Kiogora/esp32_lora_gateway/firmware/docs/protobuf-c workflow/protobuf-c_workflow.png

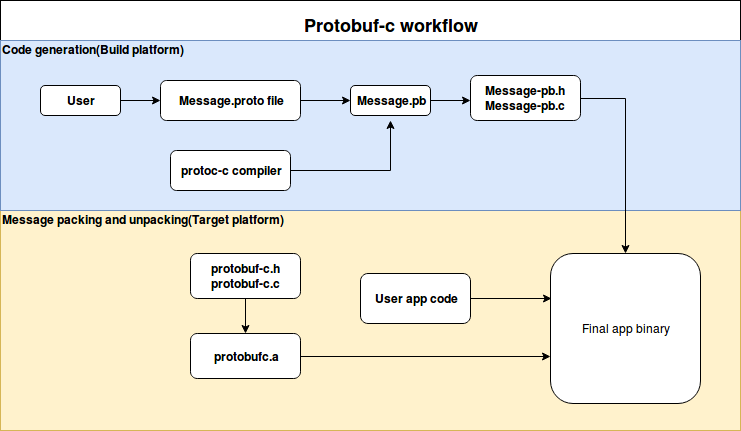
firmware/docs/protobuf-c workflow/protobuf-c_workflow.png
