Kiogora/esp32_lora_gateway/firmware/components/loboris_spiffs_image/readops/pktlog_30AEA414D4380000_20180530T070307Z.csv

gateway ID | UTC timestamp | us count | frequency | RF chain | RX chain | status | size | modulation | bandwidth | datarate | coderate | RSSI | SNR | PHY payload | MAC message type | APP-EUI | DEV-EUI | devaddr | ADR bit | Foptlen | FCnt | Fport
30AEA414D4380000 | 2018-05-30 07:03:19.973Z | 1216968428 | 867500000 | 0 | 5 | CRC_OK | 29 | LORA | 125000 | SF7 | 4/5 | -53 | +7.5 | 40B52D01-
