Kiogora/esp32_lora_gateway/hardware/prototype/prototype.xlsx

Prj: | ESP32 LoRa gateway with surge suppression |  |  |  |  |  | Board Qty: | 100
Co.: | Kaiote Limited |  |  |  |  |  | Unit Cost: | $0.00
Prj date: | Wed 09 May 2018 01:54:27 PM EAT |  |  |  |  |  | Total Cost: | $0.00 |  |  |  | $0.00 | 0
$ date: | 2018-05-09 13:54:59
Global Part Info |  |  |  |  |  |  |  |  | Digi-Key
Refs | Value | Desc | Footprint | Manf | Manf# | Qty | Unit$ | Ext$ | Avail | Purch | Unit$ | Ext$ | Cat#
AE1 | Antenna |  |  |  | TG.10.0113 | 0 | $0.00 | $0.00 | 1409 |  | $0.00 | $0.00 | 931-1163-ND (https://www.digikey.com/products/en?keywords=TG.10.0113+)
C1,C4,C5,C7,C8,C10,C14,C16 | 0.1uF |  | Capacitor_SMD:C_0805_2012Metric_Pad1.15x1.50mm_HandSolder |  | CGA4J2X7R2A104K125AA | 0 | $0.00 | $0.00 | 32967 |  | $0.00 | $0.00 | 445-5827-1-ND (https://www.digikey.com/product-detail/en/tdk-corporation/CGA4J2X7R2A104K125AA/445-5827-1-ND/2443867)
C11,C12,C15 | 220uF |  | Capacitor_SMD:CP_Elec_6.3x5.8 |  | UUD0J221MCL1GS | 0 | $0.00 | $0.00 | 99161 |  | $0.00 | $0.00 | 493-2236-1-ND (https://www.digikey.com/product-detail/en/nichicon/UUD0J221MCL1GS/493-2236-1-ND/590211)
C2 | 10uF |  | Capacitor_SMD:C_0805_2012Metric_Pad1.15x1.50mm_HandSolder |  | C2012X5R1E106M085AC (http://search.murata.co.jp/Ceramy/image/img/A01X/G101/ENG/GRM21BR61E106KA73-01.pdf) | 0 | $0.00 | $0.00 | 8071 |  | $0.00 | $0.00 | 445-14388-1-ND (https://www.digikey.com/product-detail/en/tdk-corporation/C2012X5R1E106M085AC/445-14388-1-ND/3956054)
C3 | 1uF |  | Capacitor_SMD:C_0805_2012Metric_Pad1.15x1.50mm_HandSolder |  | CC0805KKX7R7BB105 (http://www.yageo.com/documents/recent/UPY-GPHC_X7R_6.3V-to-50V_18.pdf) | 0 | $0.00 | $0.00 | 613882 |  | $0.00 | $0.00 | 311-1365-1-ND (https://www.digikey.com/product-detail/en/yageo/CC0805KKX7R7BB105/311-1365-1-ND/2103149)
C6,C13 | 10uF |  | Capacitor_SMD:C_1206_3216Metric_Pad1.24x1.80mm_HandSolder |  | C2012X5R1E106M085AC | 0 | $0.00 | $0.00 | 8071 |  | $0.00 | $0.00 | 445-14388-1-ND (https://www.digikey.com/product-detail/en/tdk-corporation/C2012X5R1E106M085AC/445-14388-1-ND/3956054)
C9 | 100pF |  | Capacitor_SMD:C_0805_2012Metric_Pad1.15x1.50mm_HandSolder |  | 06035A101FAT2A (http://datasheets.avx.com/C0GNP0-Dielectric.pdf) | 0 | $0.00 | $0.00 | 178881 |  | $0.00 | $0.00 | 478-6202-1-ND (https://www.digikey.com/product-detail/en/avx-corporation/06035A101FAT2A/478-6202-1-ND/2391401)
D1,D2 | D_TVS |  | digikey-footprints:DO-214AC |  | SMA6J12A | 0 | $0.00 | $0.00 | 67701 |  | $0.00 | $0.00 | SMA6J12ACT-ND (https://www.digikey.com/product-detail/en/littelfuse-inc/SMA6J12A/SMA6J12ACT-ND/4279585)
D3,D5,D6 | LED |  | LED_SMD:LED_0805_2012Metric_Pad0.97x1.50mm_HandSolder |  | LTST-C171KRKT (http://optoelectronics.liteon.com/upload/download/DS22-2000-109/LTST-C171KRKT.pdf) | 0 | $0.00 | $0.00 | 225429 |  | $0.00 | $0.00 | 160-1427-1-ND (https://www.digikey.com/product-detail/en/lite-on-inc/LTST-C171KRKT/160-1427-1-ND/386800)
D4 | LED |  | LED_SMD:LED_0805_2012Metric_Pad0.97x1.50mm_HandSolder |  | LTST-C171KGKT (http://optoelectronics.liteon.com/upload/download/DS22-2000-118/LTST-C171KGKT.pdf) | 0 | $0.00 | $0.00 | 258045 |  | $0.00 | $0.00 | 160-1426-1-ND (https://www.digikey.com/product-detail/en/lite-on-inc/LTST-C171KGKT/160-1426-1-ND/386798)
F1,F2 | Fuse_Small |  | lib_fp:461_series_Telelink |  | 0461002.ER | 0 | $0.00 | $0.00 | 3716 |  | $0.00 | $0.00 | F1551CT-ND (https://www.digikey.com/product-detail/en/littelfuse-inc/0461002.ER/F1551CT-ND/447217)
GDT1,GDT2 | GDT- |  | lib_fp:SL1411A075-SM |  | SL1411A075SM | 0 | $0.00 | $0.00 | 435 |  | $0.00 | $0.00 | F10923CT-ND (https://www.digikey.com/product-detail/en/littelfuse-inc/SL1411A075SM/F10923CT-ND/8109613)
J1 | Jack-DC |  |  |  | PJ-002A | 0 | $0.00 | $0.00 | 109356 |  | $0.00 | $0.00 | CP-002A-ND (https://www.digikey.com/product-detail/en/cui-inc/PJ-002A/CP-002A-ND/96962)
J10 | Conn_02x12_Odd_Even |  |  |  | PPPC072LJBN-RC | 0 | $0.00 | $0.00 | 9044 |  | $0.00 | $0.00 | S5560-ND (https://www.digikey.com/products/en?keywords=PPPC072LJBN-RC+)
J11 | Conn_02x12_Odd_Even |  |  |  | PPPC122LFBN-RC | 0 | $0.00 | $0.00 | 2519 |  | $0.00 | $0.00 | S7115-ND (https://www.digikey.com/products/en?keywords=PPPC122LFBN-RC+)
J12 | Conn_01x02 |  |  |  | SSC02SYAN | 0 | $0.00 | $0.00 | 108413 |  | $0.00 | $0.00 | S9002-ND (https://www.digikey.com/products/en?keywords=SSC02SYAN+)
J13 | Conn_02x07_Odd_Even |  |  |  | PPTC072LFBN-RC | 0 | $0.00 | $0.00 | 9951 |  | $0.00 | $0.00 | S7075-ND (https://www.digikey.com/products/en?keywords=PPTC072LFBN-RC+)
J14 | Conn_02x07_Odd_Even |  |  |  | PPPC072LJBN-RC | 0 | $0.00 | $0.00 | 9044 |  | $0.00 | $0.00 | S5560-ND (https://www.digikey.com/products/en?keywords=PPPC072LJBN-RC+)
J15,J16 | Conn_01x08 |  |  |  | PPTC081LFBN-RC | 0 | $0.00 | $0.00 | 40048 |  | $0.00 | $0.00 | S7006-ND (https://www.digikey.com/products/en?keywords=PPTC081LFBN-RC+)
J17 | RJ45 |  |  |  | RCP-5SPFFH-TCU7001 | 0 | $0.00 | $0.00 | 8007 |  | $0.00 | $0.00 | APC1766-ND (https://www.digikey.com/products/en?keywords=RCP-5SPFFH-TCU7001+)
J18 | RJ45_LED |  |  |  | ESP-100-POE | 0 | $0.00 | $0.00 | 515 |  | $0.00 | $0.00 | 994-1011-ND (https://www.digikey.com/products/en?keywords=ESP-100-POE+)
J19 | Conn_01x04 |  |  |  | PPTC041LFBN-RC | 0 | $0.00 | $0.00 | 10992 |  | $0.00 | $0.00 | S7002-ND (https://www.digikey.com/products/en?keywords=PPTC041LFBN-RC+)
J2 | 0734120114 | CONN UMC RCPT STR 50 OHM SMD | digikey-footprints:Molex_734120114_UMC_RF_CONN_Vertical | Molex, LLC | 0734120114 (http://www.molex.com/pdm_docs/sd/734120110_sd.pdf) | 0 | $0.00 | $0.00 | 36488 |  | $0.00 | $0.00 | WM5587CT-ND (https://www.digikey.com/product-detail/en/molex-llc/0734120110/WM5587CT-ND/1894612)
J20 | RJ45_Shielded |  |  |  | 1528-1773-ND | 0 | $0.00 | $0.00 | 35 |  | $0.00 | $0.00 | 1528-1773-ND (https://www.digikey.com/products/en?keywords=1528-1773-ND+)
J3 | Conn_01x04 |  | lib_fp:PinHeader_1x04_P2.54mm_staggered_Vertical |  | 1528-1504-ND | 0 | $0.00 | $0.00 | 119 |  | $0.00 | $0.00 | 1528-1504-ND (https://www.digikey.com/products/en?keywords=1528-1504-ND+)
J4 | Conn_01x04 |  | lib_fp:PinHeader_1x04_P2.54mm_staggered_Vertical |  | 801-43-050-10-001000 | 0 | $0.00 | $0.00 | 6322 |  | $0.00 | $0.00 | ED6350-50-ND (https://www.digikey.com/products/en?keywords=801-43-050-10-001000+)
J5 | Conn_02x07_Odd_Even |  | lib_fp:lan_waveshare_8720 |  |  | 0 | $0.00 | $0.00
J6 | Battery-holder |  | lib_fp:BAT-HLD-001-xx-OTL |  | BAT-HLD-001 (https://www.mouser.co.za/datasheet/2/238/bat-hld-001-220194.pdf) | 0 | $0.00 | $0.00 | 52337 |  | $0.00 | $0.00 | BAT-HLD-001-ND (https://www.digikey.com/product-detail/en/linx-technologies-inc/BAT-HLD-001/BAT-HLD-001-ND/1577235)
J7 | Conn_02x12_Odd_Even |  | lib_fp:Hybrid_concentrator |  |  | 0 | $0.00 | $0.00
J8,J9 | Conn_01x19 |  |  |  | PPTC191LFBN-RC | 0 | $0.00 | $0.00 | 1012 |  | $0.00 | $0.00 | S7017-ND (https://www.digikey.com/products/en?keywords=PPTC191LFBN-RC+)
JP1,JP21 | SolderJumper_2_Open |  | Jumper:SolderJumper-2_P1.3mm_Open_RoundedPad1.0x1.5mm |  |  | 0 | $0.00 | $0.00
JP6 | Jumper_3_Open |  | lib_fp:PinHeader_1x03_P2.54mm_staggered_Vertical |  | 61300311121 | 0 | $0.00 | $0.00 | 128874 |  | $0.00 | $0.00 | 732-5316-ND (https://www.digikey.com/products/en?keywords=61300311121+)
JP18-JP20 | Jumper |  | lib_fp:PinHeader_1x02_P2.54mm_staggered_Vertical |  | 61300211121 | 0 | $0.00 | $0.00 | 70697 |  | $0.00 | $0.00 | 732-5315-ND (https://www.digikey.com/products/en?keywords=61300211121+)
JP2-JP5,JP7-JP17 | Jumper_NC_Dual |  | lib_fp:PinHeader_1x03_P2.54mm_staggered_Vertical |  | 61300311121 | 0 | $0.00 | $0.00 | 128874 |  | $0.00 | $0.00 | 732-5316-ND (https://www.digikey.com/products/en?keywords=61300311121+)
MK1-MK4 | Mounting_Hole_PAD |  | MountingHole:MountingHole_3.2mm_M3_Pad_Via |  |  | 0 | $0.00 | $0.00
Q1 | Si2323 |  | Package_TO_SOT_SMD:SOT-23 |  | SI2323CDS-T1-GE3 (http://www.vishay.com/docs/65700/si2323cds.pdf) | 0 | $0.00 | $0.00 | 3485 |  | $0.00 | $0.00 | SI2323CDS-T1-GE3CT-ND (https://www.digikey.com/product-detail/en/vishay-siliconix/SI2323CDS-T1-GE3/SI2323CDS-T1-GE3CT-ND/2441900)
Q2 | DTC143Z |  | Package_TO_SOT_SMD:SC-59_Handsoldering |  | DTC143ZKAT146 (http://www.rohm.com/web/global/datasheet/DTC143ZEB/dtc143zebtl-e) | 0 | $0.00 | $0.00 | 31281 |  | $0.00 | $0.00 | DTC143ZKAT146CT-ND (https://www.digikey.com/product-detail/en/rohm-semiconductor/DTC143ZKAT146/DTC143ZKAT146CT-ND/650725)
R11 | 300R |  | Resistor_SMD:R_0805_2012Metric |  | ERJ-PB6D3000V (https://industrial.panasonic.com/cdbs/www-data/pdf/RDM0000/AOA0000C328.pdf) | 0 | $0.00 | $0.00 | 2815 |  | $0.00 | $0.00 | P20957CT-ND (https://www.digikey.com/product-detail/en/panasonic-electronic-components/ERJ-PB6D3000V/P20957CT-ND/6215212)
R6 | 33R |  | Resistor_SMD:R_0805_2012Metric |  | RC0805FR-0733RL (http://www.yageo.com/documents/recent/PYu-RC_Group_51_RoHS_L_9.pdf) | 0 | $0.00 | $0.00 | 403086 |  | $0.00 | $0.00 | 311-33.0CRCT-ND (https://www.digikey.com/product-detail/en/yageo/RC0805FR-0733RL/311-33.0CRCT-ND/730809)
R7 | 1.5k |  | Resistor_SMD:R_0805_2012Metric |  | ESR10EZPJ152 (http://www.rohm.com/web/global/datasheet/ESR01MZPF/esr-e) | 0 | $0.00 | $0.00 | 17084 |  | $0.00 | $0.00 | RHM1.5KKCT-ND (https://www.digikey.com/product-detail/en/rohm-semiconductor/ESR10EZPJ152/RHM1.5KKCT-ND/1762968)
R8 | 110R |  | Resistor_SMD:R_0805_2012Metric |  | CRCW0805110RFKEA (http://www.vishay.com/docs/20035/dcrcwe3.pdf) | 0 | $0.00 | $0.00 | 29426 |  | $0.00 | $0.00 | 541-110CCT-ND (https://www.digikey.com/product-detail/en/vishay-dale/CRCW0805110RFKEA/541-110CCT-ND/1180673)
R9,R10 | 130R |  | Resistor_SMD:R_0805_2012Metric |  | ERA-6AEB131V (https://industrial.panasonic.com/cdbs/www-data/pdf/RDM0000/AOA0000C307.pdf) | 0 | $0.00 | $0.00 | 18209 |  | $0.00 | $0.00 | P130DACT-ND (https://www.digikey.com/product-detail/en/panasonic-electronic-components/ERA-6AEB131V/P130DACT-ND/1465926)
R1-R5 | 10k |  | Resistor_SMD:R_0805_2012Metric |  | RR1220P-103-D | 0 | $0.00 | $0.00 | 641130 |  | $0.00 | $0.00 | RR12P10.0KDCT-ND (https://www.digikey.com/product-detail/en/susumu/RR1220P-103-D/RR12P10.0KDCT-ND/432854)
U1 | QUECTEL_L80 |  | lib_fp:QUECTEL_L80-M39 |  |  | 0 | $0.00 | $0.00
U2 | TLV71333PDBV |  | Package_TO_SOT_SMD:SOT-23-5 |  | TLV73333PDBVR (http://www.ti.com/lit/ds/symlink/tlv733p.pdf) | 0 | $0.00 | $0.00 | 5832 |  | $0.00 | $0.00 | 296-38492-1-ND (https://www.digikey.com/product-detail/en/texas-instruments/TLV73333PDBVT/296-38492-1-ND/5023884)
U3 | LM2596_MODULE |  | lib_fp:LM2596_MODULE |  |  | 0 | $0.00 | $0.00
U4 | DevkitC |  | lib_fp:ESP32_DEVKITC |  | ESP32-DEVKITC (https://www.espressif.com/sites/default/files/documentation/esp32_datasheet_en.pdf) | 0 | $0.00 | $0.00 | 440 |  | $0.00 | $0.00 | 1904-1011-ND (https://www.digikey.com/product-detail/en/espressif-systems/ESP32-DEVKITC/1904-1011-ND/8544299)
U5 | MIKROE_3G_CLICK |  | lib_fp:MIKROE_UG95 |  | MIKROE-2226 (https://download.mikroe.com/documents/add-on-boards/click/3g/3g-click-schematic-v103.pdf) | 0 | $0.00 | $0.00 | 5 |  | $0.00 | $0.00 | 1471-1619-ND (https://www.digikey.com/products/en?keywords=MIKROE-2226+)
Distributors scraped by KiCost® v.0.1.43 |  |  |  |  |  |  |  |  |  | 0
 |  |  |  |  |  |  |  |  |  | 0 | 0 | 0
 |  |  |  |  |  |  |  |  |  | 0 | 0 | 0
 |  |  |  |  |  |  |  |  |  | 0 | 0 | 0
 |  |  |  |  |  |  |  |  |  | 0 | 0 | 0
 |  |  |  |  |  |  |  |  |  | 0 | 0 | 0
 |  |  |  |  |  |  |  |  |  | 0 | 0 | 0
 |  |  |  |  |  |  |  |  |  | 0 | 0 | 0
 |  |  |  |  |  |  |  |  |  | 0 | 0 | 0
 |  |  |  |  |  |  |  |  |  | 0 | 0 | 0
 |  |  |  |  |  |  |  |  |  | 0 | 0 | 0
 |  |  |  |  |  |  |  |  |  | 0 | 0 | 0
 |  |  |  |  |  |  |  |  |  | 0 | 0 | 0
 |  |  |  |  |  |  |  |  |  | 0 | 0 | 0
 |  |  |  |  |  |  |  |  |  | 0 | 0 | 0
 |  |  |  |  |  |  |  |  |  | 0 | 0 | 0
 |  |  |  |  |  |  |  |  |  | 0 | 0 | 0
 |  |  |  |  |  |  |  |  |  | 0 | 0 | 0
 |  |  |  |  |  |  |  |  |  | 0 | 0 | 0
 |  |  |  |  |  |  |  |  |  | 0 | 0 | 0
 |  |  |  |  |  |  |  |  |  | 0 | 0 | 0
 |  |  |  |  |  |  |  |  |  | 0 | 0 | 0
 |  |  |  |  |  |  |  |  |  | 0 | 0 | 0
 |  |  |  |  |  |  |  |  |  | 0 | 0 | 0
 |  |  |  |  |  |  |  |  |  | 0 | 0 | 0
 |  |  |  |  |  |  |  |  |  | 0 | 0 | 0
 |  |  |  |  |  |  |  |  |  | 0 | 0 | 0
 |  |  |  |  |  |  |  |  |  | 0 | 0 | 0
 |  |  |  |  |  |  |  |  |  | 0 | 0 | 0
 |  |  |  |  |  |  |  |  |  | 0 | 0 | 0
 |  |  |  |  |  |  |  |  |  | 0 | 0 | 0
 |  |  |  |  |  |  |  |  |  | 0 | 0 | 0
 |  |  |  |  |  |  |  |  |  | 0 | 0 | 0
 |  |  |  |  |  |  |  |  |  | 0 | 0 | 0
 |  |  |  |  |  |  |  |  |  | 0 | 0 | 0
 |  |  |  |  |  |  |  |  |  | 0 | 0 | 0
 |  |  |  |  |  |  |  |  |  | 0 | 0 | 0
 |  |  |  |  |  |  |  |  |  | 0 | 0 | 0
 |  |  |  |  |  |  |  |  |  | 0 | 0 | 0
 |  |  |  |  |  |  |  |  |  | 0 | 0 | 0
 |  |  |  |  |  |  |  |  |  | 0 | 0 | 0
 |  |  |  |  |  |  |  |  |  | 0 | 0 | 0
 |  |  |  |  |  |  |  |  |  | 0 | 0 | 0
 |  |  |  |  |  |  |  |  |  | 0 | 0 | 0
 |  |  |  |  |  |  |  |  |  | 0 | 0 | 0
 |  |  |  |  |  |  |  |  |  | 0 | 0 | 0
 |  |  |  |  |  |  |  |  |  | 0 | 0 | 0
 |  |  |  |  |  |  |  |  |  | 0 | 0 | 0
 |  |  |  |  |  |  |  |  |  | 0 | 0 | 0
