Kiogora/esp32_lora_gateway/hardware/prototype/gerbers/prototype-Edge.Cuts.dxf

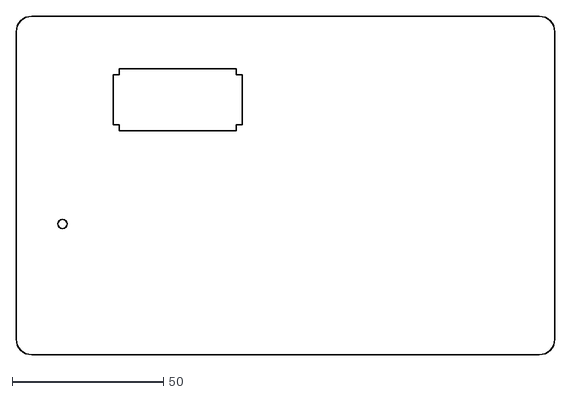
[picture p3: CAD file, 2018-06-03]
hardware/prototype/gerbers/prototype-Edge.Cuts.dxf
177.8 x 111.8
