Kiogora/esp32_lora_gateway/hardware/prototype/prototype.kicad_pcb

## KiCad design hardware/prototype/prototype.kicad_pcb (2018-05-04)

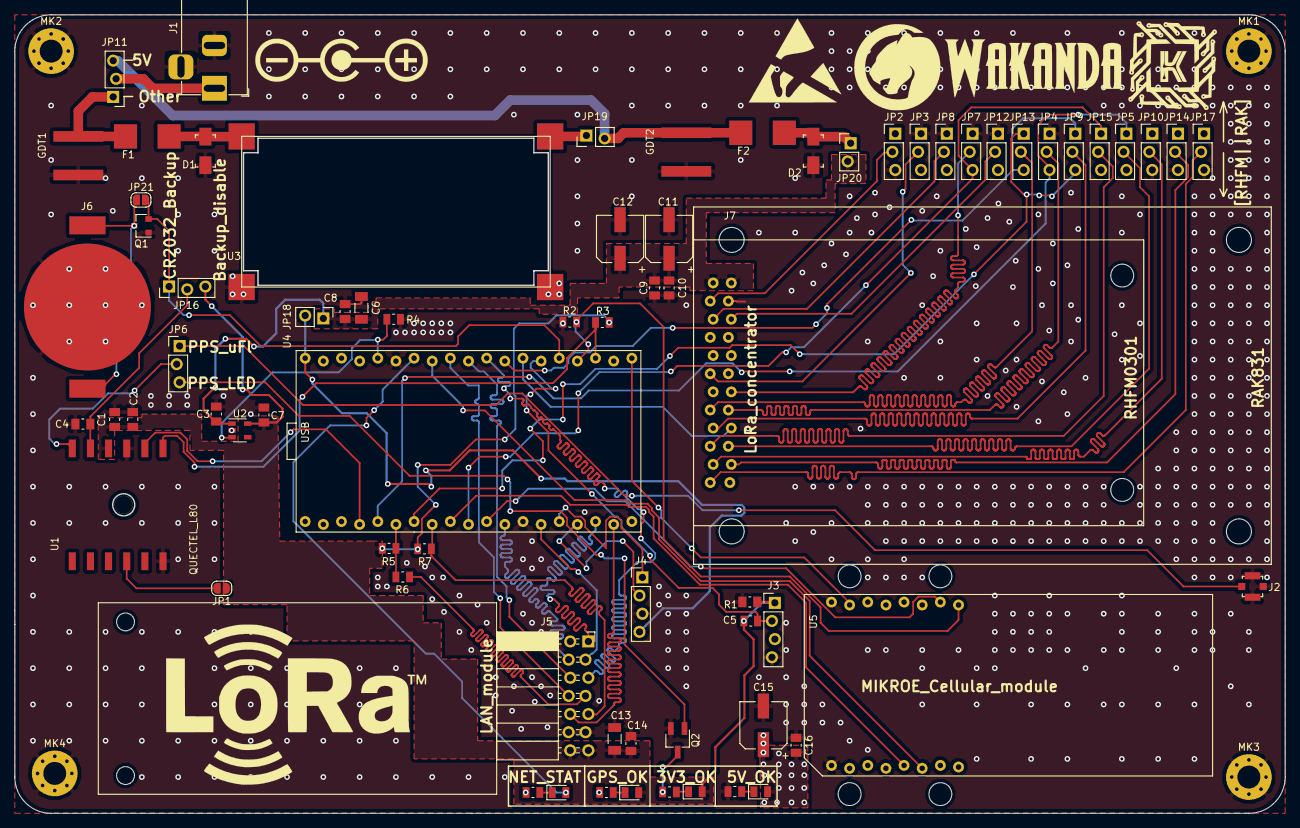
[picture p7: board prototype.kicad_pcb from above]

Board: 2 copper layers, 177.8 x 111.8 mm, 76 parts (0 on the bottom side), 62 nets.

Parts:
C1, C4, C5, C7, C8, C10, C14, C16: 0.1uF; C_0805_2012Metric_Pad1.15x1.50mm_HandSolder
C2: 10uF; C_0805_2012Metric_Pad1.15x1.50mm_HandSolder
C3: 1uF; C_0805_2012Metric_Pad1.15x1.50mm_HandSolder
C6, C13: 10uF; C_1206_3216Metric_Pad1.24x1.80mm_HandSolder
C9: 100pF; C_0805_2012Metric_Pad1.15x1.50mm_HandSolder
C11, C12, C15: 220uF; CP_Elec_6.3x5.8
D1, D2: D_TVS; DO-214AC
D3, D4, D5, D6: LED; LED_0805_2012Metric_Pad0.97x1.50mm_HandSolder
F1, F2: Fuse_Small; 461_series_Telelink
GDT1, GDT2: GDT-; SL1411A075-SM
J1: Jack-DC; BarrelJack_Horizontal
J2: 0734120114; Molex_734120114_UMC_RF_CONN_Vertical
J3, J4: Conn_01x04; PinHeader_1x04_P2.54mm_staggered_Vertical
J5: Conn_02x07_Odd_Even; lan_waveshare_8720
J6: Battery-holder; BAT-HLD-001-xx-OTL
J7: Conn_02x12_Odd_Even; Hybrid_concentrator
JP1, JP21: SolderJumper_2_Open; SolderJumper-2_P1.3mm_Open_RoundedPad1.0x1.5mm
JP2, JP3, JP4, JP5, JP7, JP8, JP9, JP10, JP11, JP12, JP13, JP14, JP15, JP16, JP17: Jumper_NC_Dual; PinHeader_1x03_P2.54mm_staggered_Vertical
JP6: Jumper_3_Open; PinHeader_1x03_P2.54mm_staggered_Vertical
JP18, JP19, JP20: Jumper; PinHeader_1x02_P2.54mm_staggered_Vertical
MK1, MK2, MK3, MK4: Mounting_Hole_PAD; MountingHole_3.2mm_M3_Pad_Via
Q1: Si2323; SOT-23
Q2: DTC143Z; SC-59_Handsoldering
R1, R2, R3: 10k; R_0805_2012Metric
R4, R5: 4.7k; R_0805_2012Metric
R6: 33R; R_0805_2012Metric
R7: 1.5k; R_0805_2012Metric
R8: 110R; R_0805_2012Metric
R9, R10: 130R; R_0805_2012Metric
R11: 300R; R_0805_2012Metric
U1: QUECTEL_L80; QUECTEL_L80-M39
U2: TLV71333PDBV; SOT-23-5
U3: LM2596_MODULE
U4: DevkitC; ESP32_DEVKITC
U5: MIKROE_3G_CLICK; MIKROE_UG95

Connections:
/3: J7.3, JP2.2
/3V3_REF: U4.20, U5.7
/5: J7.5, JP8.2
/5v_rail: F2.1, GDT2.1, JP11.3, JP19.2
/6: J7.6, JP12.2
/11: J7.11, JP3.2
/12v_rail: F1.1, GDT1.1, JP11.1
/14: J7.14, JP7.2
/15: J7.15, JP13.2
/16: J7.16, JP4.2
/17: J7.17, JP9.2
/19: J7.19, JP15.2
/20: J7.20, JP5.2
/21: J7.21, JP10.2
/22: J7.22, JP14.2
/23: J7.23, JP17.2
/BRD_GPS_1PPS: JP6.2, U1.6
/BRD_GPS_RX: R3.2, U1.1, U4.22
/BRD_GPS_TX: U1.2, U4.4
/BRD_GPS_VBCKUP: C4.2, JP16.2, U1.5
/CELLULAR_5V: C3.1, C6.1, C8.1, C9.1, C10.1, C11.1, C12.1, C15.1, C16.1, D6.2, J7.1, J7.2, JP18.1, JP20.2, U2.1, U5.15
/CONTROLLER_RX: J4.1, U4.15
/CONTROLLER_TX: J4.2, U4.16
/CSN: JP9.3, JP13.1, U4.7
/ESP32_5v: J4.4, JP18.2, U4.38
/GLOBAL_3V3: C1.1, C2.1, C5.1, C7.1, C13.1, C14.1, D3.2, D5.2, J3.1, J5.13, J5.14, JP1.1, JP16.3, R1.1, R3.1, R5.1, R7.1, U1.4, U2.5
/GSM_RX: U4.9, U5.12
/GSM_TX: U4.31, U5.11
/MISO: JP9.1, JP13.3, U4.27
/MOSI: J7.18, U4.26
/NETWORK_STATUS: D4.2, U4.32
/PHY_POWER_EN: R4.1, U2.3, U4.34
/PPS_VISUAL: JP6.3, Q2.1
/PWR_KEY: U4.11, U5.2
/Power_Input: J1.1, JP11.2
/RESET: JP7.3, JP15.1, U4.10
/RMII-RX0: J5.5, U4.28
/RMII_CRS_DV: J5.8, U4.30
/RMII_MDC: J5.10, U4.18
/RMII_MDIO: J5.9, R7.2, U4.8
/RMII_REFOSC_nINT: R5.2, R6.1, U4.6
/RMII_RX1: J5.6, U4.29
/RMII_TX0: J5.4, U4.12
/RMII_TX1: J5.1, U4.17
/RMII_TX_EN: J5.3, U4.14
/SCK: JP4.3, JP5.1, U4.5
/STATUS: R2.1, U4.23, U5.1
/TEMP_DATA: J3.2, R1.2, U4.25
/V_BCKUP: JP16.1, JP21.2, Q1.2, U4.24
GND: C1.2, C2.2, C3.2, C4.1, C5.2, C6.2, C7.2, C8.2, C9.2, C10.2, C11.2, C12.2, C13.2, C14.2, C15.2, C16.2, D1.2, D2.2, GDT1.2, GDT2.2, J1.2, J1.3, J2.1, J3.4, J4.3, J5.11, J5.12, J6.2, J7.4, JP2.3, JP3.1, JP4.1, JP7.1, JP8.1, JP10.3, JP12.1, JP14.3, JP17.3, MK1.1, MK2.1, MK3.1, MK4.1, Q1.1, Q2.2, R2.2, R4.2, R9.1, R10.1, R11.1, U1.3, U1.12, U2.2, U3.2, U3.4, U4.13, U4.19, U4.33, U5.8, U5.16
unnamed: D1.1, F1.2, U3.1
unnamed: D2.1, F2.2, JP20.1
unnamed: D3.1, R8.2
unnamed: D4.1, R9.2
unnamed: D5.1, R10.2
unnamed: D6.1, R11.2
unnamed: J2.2, JP6.1
unnamed: J5.7, R6.2
unnamed: J6.1, JP21.1, Q1.3
unnamed: JP1.2, U1.10
unnamed: JP19.1, U3.3
unnamed: Q2.3, R8.1
