Kiogora/esp32_lora_gateway/firmware/main/main.c

/*
 / _____)             _              | |
( (____  _____ ____ _| |_ _____  ____| |__
 \____ \| ___ |    (_   _) ___ |/ ___)  _ \
 _____) ) ____| | | || |_| ____( (___| | | |
(______/|_____)_|_|_| \__)_____)\____)_| |_|
  (C)2013 Semtech-Cycleo

Description:
    Configure Lora concentrator and forward packets to a server
    Use GPS for packet timestamping.
    Send a becon at a regular interval without server intervention

License: Revised BSD License, see LICENSE.TXT file include in the project
Maintainer: Michael Coracin
*/


/* -------------------------------------------------------------------------- */
/* --- DEPENDANCIES --------------------------------------------------------- */
#include <stdint.h>         /* C99 types */
#include <stdbool.h>        /* bool type */
#include <stdio.h>          /* printf, fprintf, snprintf, fopen, fputs */

#include <string.h>         /* memset */
#include <time.h>           /* time, clock_gettime, strftime, gmtime */
#include <sys/time.h>       /* timeval */
#include <unistd.h>         /* getopt, access */
#include <stdlib.h>         /* atoi, exit */
#include <errno.h>          /* error messages */
#include <math.h>           /* modf */
#include <assert.h>

#include "freertos/FreeRTOS.h"
#include "freertos/event_groups.h"
#include "freertos/task.h"
#include "freertos/semphr.h"

#include "esp_event_loop.h"
#include "esp_wifi.h"
#include "esp_system.h"
#include "esp_log.h"
#include "driver/uart.h"
#include "soc/uart_struct.h"

#include <lwip/sockets.h>     /* socket specific definitions */
#include <lwip/inet.h>      /* IP address conversion stuff */
#include <lwip/netdb.h>          /* gai_strerror */

#include <errno.h>
#include <sys/fcntl.h>
#include "esp_vfs.h"
#include "esp_vfs_fat.h"
#include "esp_log.h"
#include "spiffs_vfs.h"

#include "esp_console.h"
#include "esp_system.h"
#include "argtable3/argtable3.h"
#include "esp_partition.h"

#include "esp_log.h"
#include "nvs_flash.h"

#include "jitqueue.h"
#include "timersync.h"
#include "parson.h"
#include "base64.h"
#include "loragw_hal.h"
#include "loragw_gps.h"
#include "loragw_aux.h"
#include "loragw_reg.h"
#include "gsm.h"
#include "trace.h"

#include "lwip/err.h"
#include "apps/sntp/sntp.h"

/* -------------------------------------------------------------------------- */
/* --- PRIVATE MACROS ------------------------------------------------------- */

#define ARRAY_SIZE(a)   (sizeof(a) / sizeof((a)[0]))
#define STRINGIFY(x)    #x
#define STR(x)          STRINGIFY(x)

/* -------------------------------------------------------------------------- */
/* --- PRIVATE CONSTANTS ---------------------------------------------------- */

#ifndef VERSION_STRING
  #define VERSION_STRING "undefined"
#endif

#define DEFAULT_SERVER      127.0.0.1   /* hostname also supported */
#define DEFAULT_PORT_UP     1780
#define DEFAULT_PORT_DW     1782
#define DEFAULT_KEEPALIVE   5           /* default time interval for downstream keep-alive packet */
#define DEFAULT_STAT        30          /* default time interval for statistics */
#define PUSH_TIMEOUT_MS     100
#define PULL_TIMEOUT_MS     200
#define GPS_REF_MAX_AGE     30          /* maximum admitted delay in seconds of GPS loss before considering latest GPS sync unusable */
#define FETCH_SLEEP_MS      10          /* nb of ms waited when a fetch return no packets */
#define BEACON_POLL_MS      50          /* time in ms between polling of beacon TX status */

#define PROTOCOL_VERSION    2           /* v1.3 */

#define XERR_INIT_AVG       128         /* nb of measurements the XTAL correction is averaged on as initial value */
#define XERR_FILT_COEF      256         /* coefficient for low-pass XTAL error tracking */

#define PKT_PUSH_DATA   0
#define PKT_PUSH_ACK    1
#define PKT_PULL_DATA   2
#define PKT_PULL_RESP   3
#define PKT_PULL_ACK    4
#define PKT_TX_ACK      5

#define NB_PKT_MAX      8 /* max number of packets per fetch/send cycle */

#define MIN_LORA_PREAMB 6 /* minimum Lora preamble length for this application */
#define STD_LORA_PREAMB 8
#define MIN_FSK_PREAMB  3 /* minimum FSK preamble length for this application */
#define STD_FSK_PREAMB  5

#define STATUS_SIZE     200
#define TX_BUFF_SIZE    ((540 * NB_PKT_MAX) + 30 + STATUS_SIZE)

#define UNIX_GPS_EPOCH_OFFSET 315964800 /* Number of seconds ellapsed between 01.Jan.1970 00:00:00
                                                                          and 06.Jan.1980 00:00:00 */

#define DEFAULT_BEACON_FREQ_HZ      869525000
#define DEFAULT_BEACON_FREQ_NB      1
#define DEFAULT_BEACON_FREQ_STEP    0
#define DEFAULT_BEACON_DATARATE     9
#define DEFAULT_BEACON_BW_HZ        125000
#define DEFAULT_BEACON_POWER        14
#define DEFAULT_BEACON_INFODESC     0

#ifndef SPI_SPEED
#define SPI_SPEED 8000000
#endif

/* -------------------------------------------------------------------------- */
/* --- PRIVATE VARIABLES (GLOBAL) ------------------------------------------- */

#define EXAMPLE_WIFI_SSID "EED Sky"
#define EXAMPLE_WIFI_PASS "20150815"

/* FreeRTOS event group to signal when we are connected & ready to make a request */
static EventGroupHandle_t wifi_event_group;

/* The event group allows multiple bits for each event,
   but we only care about one event - are we connected
   to the AP with an IP? */
const static int CONNECTED_BIT = BIT0;

static const char *TAG = "[LORA_PKT_FWD]";
static const char *WIFI_TAG = "[WIFI_SYS]";

/* packets filtering configuration variables */
static bool fwd_valid_pkt = true; /* packets with PAYLOAD CRC OK are forwarded */
static bool fwd_error_pkt = false; /* packets with PAYLOAD CRC ERROR are NOT forwarded */
static bool fwd_nocrc_pkt = false; /* packets with NO PAYLOAD CRC are NOT forwarded */

/* network configuration variables */
static uint8_t mac_val[8] = {0};
static uint64_t lgwm = 0; /* Lora gateway MAC address */
static char serv_addr[64] = STR(DEFAULT_SERVER); /* address of the server (host name or IPv4/IPv6) */
static char serv_port_up[8] = STR(DEFAULT_PORT_UP); /* server port for upstream traffic */
static char serv_port_down[8] = STR(DEFAULT_PORT_DW); /* server port for downstream traffic */
static int keepalive_time = DEFAULT_KEEPALIVE; /* send a PULL_DATA request every X seconds, negative = disabled */

/* statistics collection configuration variables */
static unsigned stat_interval = DEFAULT_STAT; /* time interval (in sec) at which statistics are collected and displayed */

/* gateway <-> MAC protocol variables */
static uint32_t net_mac_h; /* Most Significant Nibble, network order */
static uint32_t net_mac_l; /* Least Significant Nibble, network order */

/* network sockets */
static int sock_up; /* socket for upstream traffic */
static int sock_down; /* socket for downstream traffic */

/* network protocol variables */
static struct timeval push_timeout_half = {0, (PUSH_TIMEOUT_MS * 500)}; /* cut in half, critical for throughput */
static struct timeval pull_timeout = {0, (PULL_TIMEOUT_MS * 1000)}; /* non critical for throughput */

/*Jit queue access control*/
SemaphoreHandle_t mx_jit_queue = NULL; /* control access to JIT queue */

/* hardware access control and correction */
//pthread_mutex_t mx_concent = PTHREAD_MUTEX_INITIALIZER;
SemaphoreHandle_t mx_concent = NULL; /* control access to the concentrator */
//static pthread_mutex_t mx_xcorr = PTHREAD_MUTEX_INITIALIZER; 
static SemaphoreHandle_t mx_xcorr = NULL; /* control access to the XTAL correction */
static bool xtal_correct_ok = false; /* set true when XTAL correction is stable enough */
static double xtal_correct = 1.0;

/* GPS configuration and synchronization */
int gps_tty_dev; /* descriptor to the serial port of the GNSS module */
static bool gps_enabled = false; /* is GPS enabled on that gateway ? */

/* GPS time reference */
//static pthread_mutex_t mx_timeref = PTHREAD_MUTEX_INITIALIZER;
static SemaphoreHandle_t mx_timeref = NULL; /* control access to GPS time reference */
static bool gps_ref_valid; /* is GPS reference acceptable (ie. not too old) */
static struct tref time_reference_gps; /* time reference used for GPS <-> timestamp conversion */

/* Reference coordinates, for broadcasting (beacon) */
static struct coord_s reference_coord;

/* Enable faking the GPS coordinates of the gateway */
static bool gps_fake_enable; /* enable the feature */

/* measurements to establish statistics */
//static pthread_mutex_t mx_meas_up = PTHREAD_MUTEX_INITIALIZER;
static SemaphoreHandle_t mx_meas_up = NULL; /* control access to the upstream measurements */
static uint32_t meas_nb_rx_rcv = 0; /* count packets received */
static uint32_t meas_nb_rx_ok = 0; /* count packets received with PAYLOAD CRC OK */
static uint32_t meas_nb_rx_bad = 0; /* count packets received with PAYLOAD CRC ERROR */
static uint32_t meas_nb_rx_nocrc = 0; /* count packets received with NO PAYLOAD CRC */
static uint32_t meas_up_pkt_fwd = 0; /* number of radio packet forwarded to the server */
static uint32_t meas_up_network_byte = 0; /* sum of UDP bytes sent for upstream traffic */
static uint32_t meas_up_payload_byte = 0; /* sum of radio payload bytes sent for upstream traffic */
static uint32_t meas_up_dgram_sent = 0; /* number of datagrams sent for upstream traffic */
static uint32_t meas_up_ack_rcv = 0; /* number of datagrams acknowledged for upstream traffic */

//static pthread_mutex_t mx_meas_dw = PTHREAD_MUTEX_INITIALIZER;
static SemaphoreHandle_t mx_meas_dw = NULL; /* control access to the downstream measurements */
static uint32_t meas_dw_pull_sent = 0; /* number of PULL requests sent for downstream traffic */
static uint32_t meas_dw_ack_rcv = 0; /* number of PULL requests acknowledged for downstream traffic */
static uint32_t meas_dw_dgram_rcv = 0; /* count PULL response packets received for downstream traffic */
static uint32_t meas_dw_network_byte = 0; /* sum of UDP bytes sent for upstream traffic */
static uint32_t meas_dw_payload_byte = 0; /* sum of radio payload bytes sent for upstream traffic */
static uint32_t meas_nb_tx_ok = 0; /* count packets emitted successfully */
static uint32_t meas_nb_tx_fail = 0; /* count packets were TX failed for other reasons */
static uint32_t meas_nb_tx_requested = 0; /* count TX request from server (downlinks) */
static uint32_t meas_nb_tx_rejected_collision_packet = 0; /* count packets were TX request were rejected due to collision with another packet already programmed */
static uint32_t meas_nb_tx_rejected_collision_beacon = 0; /* count packets were TX request were rejected due to collision with a beacon already programmed */
static uint32_t meas_nb_tx_rejected_too_late = 0; /* count packets were TX request were rejected because it is too late to program it */
static uint32_t meas_nb_tx_rejected_too_early = 0; /* count packets were TX request were rejected because timestamp is too much in advance */
static uint32_t meas_nb_beacon_queued = 0; /* count beacon inserted in jit queue */
static uint32_t meas_nb_beacon_sent = 0; /* count beacon actually sent to concentrator */
static uint32_t meas_nb_beacon_rejected = 0; /* count beacon rejected for queuing */

//static pthread_mutex_t mx_meas_gps = PTHREAD_MUTEX_INITIALIZER;
static SemaphoreHandle_t mx_meas_gps = NULL; /* control access to the GPS statistics */
static bool gps_coord_valid; /* could we get valid GPS coordinates ? */
static struct coord_s meas_gps_coord={0.0,0.0,0}; /* GPS position of the gateway */
static struct coord_s meas_gps_err={0.0,0.0,0}; /* GPS position of the gateway */

//static pthread_mutex_t mx_stat_rep = PTHREAD_MUTEX_INITIALIZER;
static SemaphoreHandle_t mx_stat_rep = NULL; /* control access to the status report */
static bool report_ready = false; /* true when there is a new report to send to the server */
static char status_report[STATUS_SIZE]; /* status report as a JSON object */

/* beacon parameters */
static uint32_t beacon_period = 0; /* set beaconing period, must be a sub-multiple of 86400, the nb of sec in a day */
static uint32_t beacon_freq_hz = DEFAULT_BEACON_FREQ_HZ; /* set beacon TX frequency, in Hz */
static uint8_t beacon_freq_nb = DEFAULT_BEACON_FREQ_NB; /* set number of beaconing channels beacon */
static uint32_t beacon_freq_step = DEFAULT_BEACON_FREQ_STEP; /* set frequency step between beacon channels, in Hz */
static uint8_t beacon_datarate = DEFAULT_BEACON_DATARATE; /* set beacon datarate (SF) */
static uint32_t beacon_bw_hz = DEFAULT_BEACON_BW_HZ; /* set beacon bandwidth, in Hz */
static int8_t beacon_power = DEFAULT_BEACON_POWER; /* set beacon TX power, in dBm */
static uint8_t beacon_infodesc = DEFAULT_BEACON_INFODESC; /* set beacon information descriptor */

/* auto-quit function */
static uint32_t autoquit_threshold = 0; /* enable auto-quit after a number of non-acknowledged PULL_DATA (0 = disabled)*/

/* Just In Time TX scheduling */
static struct jit_queue_s jit_queue;

/* Gateway specificities */
static int8_t antenna_gain = 0;

/* TX capabilities */
static struct lgw_tx_gain_lut_s txlut; /* TX gain table */
static uint32_t tx_freq_min[LGW_RF_CHAIN_NB]; /* lowest frequency supported by TX chain */
static uint32_t tx_freq_max[LGW_RF_CHAIN_NB]; /* highest frequency supported by TX chain */

/* -------------------------------------------------------------------------- */
/* --- PRIVATE FUNCTIONS DECLARATION ---------------------------------------- */

static int parse_SX1301_configuration(const char * conf_file);

static int parse_gateway_configuration(const char * conf_file);

static uint16_t crc16(const uint8_t * data, unsigned size);

static double difftimeval(struct timeval end, struct timeval beginning);

static void obtain_time(void);
static void initialize_sntp(void);
static void initialise_wifi(void);
static esp_err_t event_handler(void *ctx, system_event_t *event);

//static double difftimespec(struct timespec end, struct timespec beginning);

static void gps_process_sync(void);

static void gps_process_coords(void);

/* tasks */
static void task_stats(void *pvParameters);
static void task_up(void *pvParameters);
static void task_down(void *pvParameters);
static void task_gps(void *pvParameters);
static void task_valid(void *pvParameters);
static void task_jit(void *pvParameters);
void task_timersync(void *pvParameters);

/*
void thread_up(void);
void thread_down(void);
void thread_gps(void);
void thread_valid(void);
void thread_jit(void);
void thread_timersync(void);
*/

/* -------------------------------------------------------------------------- */
/* --- PRIVATE FUNCTIONS DEFINITION ----------------------------------------- */
static int parse_SX1301_configuration(const char * conf_file) {
    int i;
    char param_name[32]; /* used to generate variable parameter names */
    const char *str; /* used to store string value from JSON object */
    const char conf_obj_name[] = "SX1301_conf_rak831";
    JSON_Value *root_val = NULL;
    JSON_Object *conf_obj = NULL;
    JSON_Object *conf_lbt_obj = NULL;
    JSON_Object *conf_lbtchan_obj = NULL;
    JSON_Value *val = NULL;
    JSON_Array *conf_array = NULL;
    struct lgw_conf_board_s boardconf;
    struct lgw_conf_lbt_s lbtconf;
    struct lgw_conf_rxrf_s rfconf;
    struct lgw_conf_rxif_s ifconf;
    uint32_t sf, bw, fdev;

    /* try to parse JSON */
    root_val = json_parse_file_with_comments(conf_file);
    if (root_val == NULL) {
        ESP_LOGI(TAG, "ERROR: %s is not a valid JSON file", conf_file);
        esp_restart();
    }

    /* point to the gateway configuration object */
    conf_obj = json_object_get_object(json_value_get_object(root_val), conf_obj_name);
    if (conf_obj == NULL) {
        ESP_LOGI(TAG, "INFO: %s does not contain a JSON object named %s", conf_file, conf_obj_name);
        return -1;
    } else {
        ESP_LOGI(TAG, "INFO: %s does contain a JSON object named %s, parsing SX1301 parameters", conf_file, conf_obj_name);
    }

    /* set board configuration */
    memset(&boardconf, 0, sizeof boardconf); /* initialize configuration structure */
    val = json_object_get_value(conf_obj, "lorawan_public"); /* fetch value (if possible) */
    if (json_value_get_type(val) == JSONBoolean) {
        boardconf.lorawan_public = (bool)json_value_get_boolean(val);
    } else {
        ESP_LOGW(TAG, "WARNING: Data type for lorawan_public seems wrong, please check");
        boardconf.lorawan_public = false;
    }
    val = json_object_get_value(conf_obj, "clksrc"); /* fetch value (if possible) */
    if (json_value_get_type(val) == JSONNumber) {
        boardconf.clksrc = (uint8_t)json_value_get_number(val);
    } else {
        ESP_LOGW(TAG, "WARNING: Data type for clksrc seems wrong, please check");
        boardconf.clksrc = 0;
    }
    ESP_LOGI(TAG, "INFO: lorawan_public %d, clksrc %d", boardconf.lorawan_public, boardconf.clksrc);
    /* all parameters parsed, submitting configuration to the HAL */
    if (lgw_board_setconf(boardconf) != LGW_HAL_SUCCESS) {
        ESP_LOGI(TAG, "ERROR: Failed to configure board");
        return -1;
    }

    /* set LBT configuration */
    memset(&lbtconf, 0, sizeof lbtconf); /* initialize configuration structure */
    conf_lbt_obj = json_object_get_object(conf_obj, "lbt_cfg"); /* fetch value (if possible) */
    if (conf_lbt_obj == NULL) {
        ESP_LOGI(TAG, "INFO: no configuration for LBT");
    } else {
        val = json_object_get_value(conf_lbt_obj, "enable"); /* fetch value (if possible) */
        if (json_value_get_type(val) == JSONBoolean) {
            lbtconf.enable = (bool)json_value_get_boolean(val);
        } else {
            ESP_LOGW(TAG, "WARNING: Data type for lbt_cfg.enable seems wrong, please check");
            lbtconf.enable = false;
        }
        if (lbtconf.enable == true) {
            val = json_object_get_value(conf_lbt_obj, "rssi_target"); /* fetch value (if possible) */
            if (json_value_get_type(val) == JSONNumber) {
                lbtconf.rssi_target = (int8_t)json_value_get_number(val);
            } else {
                ESP_LOGW(TAG, "WARNING: Data type for lbt_cfg.rssi_target seems wrong, please check");
                lbtconf.rssi_target = 0;
            }
            val = json_object_get_value(conf_lbt_obj, "sx127x_rssi_offset"); /* fetch value (if possible) */
            if (json_value_get_type(val) == JSONNumber) {
                lbtconf.rssi_offset = (int8_t)json_value_get_number(val);
            } else {
                ESP_LOGW(TAG, "WARNING: Data type for lbt_cfg.sx127x_rssi_offset seems wrong, please check");
                lbtconf.rssi_offset = 0;
            }
            /* set LBT channels configuration */
            conf_array = json_object_get_array(conf_lbt_obj, "chan_cfg");
            if (conf_array != NULL) {
                lbtconf.nb_channel = json_array_get_count( conf_array );
                ESP_LOGI(TAG, "INFO: %u LBT channels configured", lbtconf.nb_channel);
            }
            for (i = 0; i < (int)lbtconf.nb_channel; i++) {
                /* Sanity check */
                if (i >= LBT_CHANNEL_FREQ_NB)
                {
                    ESP_LOGE(TAG, "ERROR: LBT channel %d not supported, skip it", i );
                    break;
                }
                /* Get LBT channel configuration object from array */
                conf_lbtchan_obj = json_array_get_object(conf_array, i);

                /* Channel frequency */
                val = json_object_dotget_value(conf_lbtchan_obj, "freq_hz"); /* fetch value (if possible) */
                if (json_value_get_type(val) == JSONNumber) {
                    lbtconf.channels[i].freq_hz = (uint32_t)json_value_get_number(val);
                } else {
                    ESP_LOGW(TAG, "WARNING: Data type for lbt_cfg.channels[%d].freq_hz seems wrong, please check", i);
                    lbtconf.channels[i].freq_hz = 0;
                }

                /* Channel scan time */
                val = json_object_dotget_value(conf_lbtchan_obj, "scan_time_us"); /* fetch value (if possible) */
                if (json_value_get_type(val) == JSONNumber) {
                    lbtconf.channels[i].scan_time_us = (uint16_t)json_value_get_number(val);
                } else {
                    ESP_LOGW(TAG, "WARNING: Data type for lbt_cfg.channels[%d].scan_time_us seems wrong, please check", i);
                    lbtconf.channels[i].scan_time_us = 0;
                }
            }

            /* all parameters parsed, submitting configuration to the HAL */
            if (lgw_lbt_setconf(lbtconf) != LGW_HAL_SUCCESS) {
                ESP_LOGE(TAG, "ERROR: Failed to configure LBT");
                return -1;
            }
        } else {
            ESP_LOGI(TAG, "INFO: LBT is disabled");
        }
    }

    /* set antenna gain configuration */
    val = json_object_get_value(conf_obj, "antenna_gain"); /* fetch value (if possible) */
    if (val != NULL) {
        if (json_value_get_type(val) == JSONNumber) {
            antenna_gain = (int8_t)json_value_get_number(val);
        } else {
            ESP_LOGW(TAG, "WARNING: Data type for antenna_gain seems wrong, please check");
            antenna_gain = 0;
        }
    }
    ESP_LOGI(TAG, "INFO: antenna_gain %d dBi", antenna_gain);

    /* set configuration for tx gains */
    memset(&txlut, 0, sizeof txlut); /* initialize configuration structure */
    for (i = 0; i < TX_GAIN_LUT_SIZE_MAX; i++) {
        snprintf(param_name, sizeof param_name, "tx_lut_%i", i); /* compose parameter path inside JSON structure */
        val = json_object_get_value(conf_obj, param_name); /* fetch value (if possible) */
        if (json_value_get_type(val) != JSONObject) {
            ESP_LOGI(TAG, "INFO: no configuration for tx gain lut %i", i);
            continue;
        }
        txlut.size++; /* update TX LUT size based on JSON object found in configuration file */
        /* there is an object to configure that TX gain index, let's parse it */
        snprintf(param_name, sizeof param_name, "tx_lut_%i.pa_gain", i);
        val = json_object_dotget_value(conf_obj, param_name);
        if (json_value_get_type(val) == JSONNumber) {
            txlut.lut[i].pa_gain = (uint8_t)json_value_get_number(val);
        } else {
            ESP_LOGW(TAG, "WARNING: Data type for %s[%d] seems wrong, please check", param_name, i);
            txlut.lut[i].pa_gain = 0;
        }
        snprintf(param_name, sizeof param_name, "tx_lut_%i.dac_gain", i);
        val = json_object_dotget_value(conf_obj, param_name);
        if (json_value_get_type(val) == JSONNumber) {
            txlut.lut[i].dac_gain = (uint8_t)json_value_get_number(val);
        } else {
            txlut.lut[i].dac_gain = 3; /* This is the only dac_gain supported for now */
        }
        snprintf(param_name, sizeof param_name, "tx_lut_%i.dig_gain", i);
        val = json_object_dotget_value(conf_obj, param_name);
        if (json_value_get_type(val) == JSONNumber) {
            txlut.lut[i].dig_gain = (uint8_t)json_value_get_number(val);
        } else {
            ESP_LOGW(TAG, "WARNING: Data type for %s[%d] seems wrong, please check", param_name, i);
            txlut.lut[i].dig_gain = 0;
        }
        snprintf(param_name, sizeof param_name, "tx_lut_%i.mix_gain", i);
        val = json_object_dotget_value(conf_obj, param_name);
        if (json_value_get_type(val) == JSONNumber) {
            txlut.lut[i].mix_gain = (uint8_t)json_value_get_number(val);
        } else {
            ESP_LOGW(TAG, "WARNING: Data type for %s[%d] seems wrong, please check", param_name, i);
            txlut.lut[i].mix_gain = 0;
        }
        snprintf(param_name, sizeof param_name, "tx_lut_%i.rf_power", i);
        val = json_object_dotget_value(conf_obj, param_name);
        if (json_value_get_type(val) == JSONNumber) {
            txlut.lut[i].rf_power = (int8_t)json_value_get_number(val);
        } else {
            ESP_LOGW(TAG, "WARNING: Data type for %s[%d] seems wrong, please check", param_name, i);
            txlut.lut[i].rf_power = 0;
        }
    }
    /* all parameters parsed, submitting configuration to the HAL */
    if (txlut.size > 0) {
        ESP_LOGI(TAG, "INFO: Configuring TX LUT with %u indexes", txlut.size);
        if (lgw_txgain_setconf(&txlut) != LGW_HAL_SUCCESS) {
            ESP_LOGI(TAG, "ERROR: Failed to configure concentrator TX Gain LUT");
            return -1;
        }
    } else {
        ESP_LOGW(TAG, "WARNING: No TX gain LUT defined");
    }

    /* set configuration for RF chains */
    for (i = 0; i < LGW_RF_CHAIN_NB; ++i) {
        memset(&rfconf, 0, sizeof rfconf); /* initialize configuration structure */
        snprintf(param_name, sizeof param_name, "radio_%i", i); /* compose parameter path inside JSON structure */
        val = json_object_get_value(conf_obj, param_name); /* fetch value (if possible) */
        if (json_value_get_type(val) != JSONObject) {
            ESP_LOGI(TAG, "INFO: no configuration for radio %i", i);
            continue;
        }
        /* there is an object to configure that radio, let's parse it */
        snprintf(param_name, sizeof param_name, "radio_%i.enable", i);
        val = json_object_dotget_value(conf_obj, param_name);
        if (json_value_get_type(val) == JSONBoolean) {
            rfconf.enable = (bool)json_value_get_boolean(val);
        } else {
            rfconf.enable = false;
        }
        if (rfconf.enable == false) { /* radio disabled, nothing else to parse */
            ESP_LOGI(TAG, "INFO: radio %i disabled", i);
        } else  { /* radio enabled, will parse the other parameters */
            snprintf(param_name, sizeof param_name, "radio_%i.freq", i);
            rfconf.freq_hz = (uint32_t)json_object_dotget_number(conf_obj, param_name);
            snprintf(param_name, sizeof param_name, "radio_%i.rssi_offset", i);
            rfconf.rssi_offset = (float)json_object_dotget_number(conf_obj, param_name);
            snprintf(param_name, sizeof param_name, "radio_%i.type", i);
            str = json_object_dotget_string(conf_obj, param_name);
            if (!strncmp(str, "SX1255", 6)) {
                rfconf.type = LGW_RADIO_TYPE_SX1255;
            } else if (!strncmp(str, "SX1257", 6)) {
                rfconf.type = LGW_RADIO_TYPE_SX1257;
            } else {
                ESP_LOGW(TAG, "WARNING: invalid radio type: %s (should be SX1255 or SX1257)", str);
            }
            snprintf(param_name, sizeof param_name, "radio_%i.tx_enable", i);
            val = json_object_dotget_value(conf_obj, param_name);
            if (json_value_get_type(val) == JSONBoolean) {
                rfconf.tx_enable = (bool)json_value_get_boolean(val);
                if (rfconf.tx_enable == true) {
                    /* tx is enabled on this rf chain, we need its frequency range */
                    snprintf(param_name, sizeof param_name, "radio_%i.tx_freq_min", i);
                    tx_freq_min[i] = (uint32_t)json_object_dotget_number(conf_obj, param_name);
                    snprintf(param_name, sizeof param_name, "radio_%i.tx_freq_max", i);
                    tx_freq_max[i] = (uint32_t)json_object_dotget_number(conf_obj, param_name);
                    if ((tx_freq_min[i] == 0) || (tx_freq_max[i] == 0)) {
                        ESP_LOGW(TAG, "WARNING: no frequency range specified for TX rf chain %d", i);
                    }
                    /* ... and the notch filter frequency to be set */
                    snprintf(param_name, sizeof param_name, "radio_%i.tx_notch_freq", i);
                    rfconf.tx_notch_freq = (uint32_t)json_object_dotget_number(conf_obj, param_name);
                }
            } else {
                rfconf.tx_enable = false;
            }
            ESP_LOGI(TAG, "INFO: radio %i enabled (type %s), center frequency %u, RSSI offset %f, tx enabled %d, tx_notch_freq %u", i, str, rfconf.freq_hz, rfconf.rssi_offset, rfconf.tx_enable, rfconf.tx_notch_freq);
        }
        /* all parameters parsed, submitting configuration to the HAL */
        if (lgw_rxrf_setconf(i, rfconf) != LGW_HAL_SUCCESS) {
            ESP_LOGE(TAG, "ERROR: invalid configuration for radio %i", i);
            return -1;
        }
    }

    /* set configuration for Lora multi-SF channels (bandwidth cannot be set) */
    for (i = 0; i < LGW_MULTI_NB; ++i) {
        memset(&ifconf, 0, sizeof ifconf); /* initialize configuration structure */
        snprintf(param_name, sizeof param_name, "chan_multiSF_%i", i); /* compose parameter path inside JSON structure */
        val = json_object_get_value(conf_obj, param_name); /* fetch value (if possible) */
        if (json_value_get_type(val) != JSONObject) {
            ESP_LOGI(TAG, "INFO: no configuration for Lora multi-SF channel %i", i);
            continue;
        }
        /* there is an object to configure that Lora multi-SF channel, let's parse it */
        snprintf(param_name, sizeof param_name, "chan_multiSF_%i.enable", i);
        val = json_object_dotget_value(conf_obj, param_name);
        if (json_value_get_type(val) == JSONBoolean) {
            ifconf.enable = (bool)json_value_get_boolean(val);
        } else {
            ifconf.enable = false;
        }
        if (ifconf.enable == false) { /* Lora multi-SF channel disabled, nothing else to parse */
            ESP_LOGI(TAG, "INFO: Lora multi-SF channel %i disabled", i);
        } else  { /* Lora multi-SF channel enabled, will parse the other parameters */
            snprintf(param_name, sizeof param_name, "chan_multiSF_%i.radio", i);
            ifconf.rf_chain = (uint32_t)json_object_dotget_number(conf_obj, param_name);
            snprintf(param_name, sizeof param_name, "chan_multiSF_%i.if", i);
            ifconf.freq_hz = (int32_t)json_object_dotget_number(conf_obj, param_name);
            // TODO: handle individual SF enabling and disabling (spread_factor)
            ESP_LOGI(TAG, "INFO: Lora multi-SF channel %i>  radio %i, IF %i Hz, 125 kHz bw, SF 7 to 12", i, ifconf.rf_chain, ifconf.freq_hz);
        }
        /* all parameters parsed, submitting configuration to the HAL */
        if (lgw_rxif_setconf(i, ifconf) != LGW_HAL_SUCCESS) {
            ESP_LOGE(TAG, "ERROR: invalid configuration for Lora multi-SF channel %i", i);
            return -1;
        }
    }

    /* set configuration for Lora standard channel */
    memset(&ifconf, 0, sizeof ifconf); /* initialize configuration structure */
    val = json_object_get_value(conf_obj, "chan_Lora_std"); /* fetch value (if possible) */
    if (json_value_get_type(val) != JSONObject) {
        ESP_LOGI(TAG, "INFO: no configuration for Lora standard channel");
    } else {
        val = json_object_dotget_value(conf_obj, "chan_Lora_std.enable");
        if (json_value_get_type(val) == JSONBoolean) {
            ifconf.enable = (bool)json_value_get_boolean(val);
        } else {
            ifconf.enable = false;
        }
        if (ifconf.enable == false) {
            ESP_LOGI(TAG, "INFO: Lora standard channel %i disabled", i);
        } else  {
            ifconf.rf_chain = (uint32_t)json_object_dotget_number(conf_obj, "chan_Lora_std.radio");
            ifconf.freq_hz = (int32_t)json_object_dotget_number(conf_obj, "chan_Lora_std.if");
            bw = (uint32_t)json_object_dotget_number(conf_obj, "chan_Lora_std.bandwidth");
            switch(bw) {
                case 500000: ifconf.bandwidth = BW_500KHZ; break;
                case 250000: ifconf.bandwidth = BW_250KHZ; break;
                case 125000: ifconf.bandwidth = BW_125KHZ; break;
                default: ifconf.bandwidth = BW_UNDEFINED;
            }
            sf = (uint32_t)json_object_dotget_number(conf_obj, "chan_Lora_std.spread_factor");
            switch(sf) {
                case  7: ifconf.datarate = DR_LORA_SF7;  break;
                case  8: ifconf.datarate = DR_LORA_SF8;  break;
                case  9: ifconf.datarate = DR_LORA_SF9;  break;
                case 10: ifconf.datarate = DR_LORA_SF10; break;
                case 11: ifconf.datarate = DR_LORA_SF11; break;
                case 12: ifconf.datarate = DR_LORA_SF12; break;
                default: ifconf.datarate = DR_UNDEFINED;
            }
            ESP_LOGI(TAG, "INFO: Lora std channel> radio %i, IF %i Hz, %u Hz bw, SF %u", ifconf.rf_chain, ifconf.freq_hz, bw, sf);
        }
        if (lgw_rxif_setconf(8, ifconf) != LGW_HAL_SUCCESS) {
            ESP_LOGE(TAG, "ERROR: invalid configuration for Lora standard channel");
            return -1;
        }
    }

    /* set configuration for FSK channel */
    memset(&ifconf, 0, sizeof ifconf); /* initialize configuration structure */
    val = json_object_get_value(conf_obj, "chan_FSK"); /* fetch value (if possible) */
    if (json_value_get_type(val) != JSONObject) {
        ESP_LOGI(TAG, "INFO: no configuration for FSK channel");
    } else {
        val = json_object_dotget_value(conf_obj, "chan_FSK.enable");
        if (json_value_get_type(val) == JSONBoolean) {
            ifconf.enable = (bool)json_value_get_boolean(val);
        } else {
            ifconf.enable = false;
        }
        if (ifconf.enable == false) {
            ESP_LOGI(TAG, "INFO: FSK channel %i disabled", i);
        } else  {
            ifconf.rf_chain = (uint32_t)json_object_dotget_number(conf_obj, "chan_FSK.radio");
            ifconf.freq_hz = (int32_t)json_object_dotget_number(conf_obj, "chan_FSK.if");
            bw = (uint32_t)json_object_dotget_number(conf_obj, "chan_FSK.bandwidth");
            fdev = (uint32_t)json_object_dotget_number(conf_obj, "chan_FSK.freq_deviation");
            ifconf.datarate = (uint32_t)json_object_dotget_number(conf_obj, "chan_FSK.datarate");

            /* if chan_FSK.bandwidth is set, it has priority over chan_FSK.freq_deviation */
            if ((bw == 0) && (fdev != 0)) {
                bw = 2 * fdev + ifconf.datarate;
            }
            if      (bw == 0)      ifconf.bandwidth = BW_UNDEFINED;
            else if (bw <= 7800)   ifconf.bandwidth = BW_7K8HZ;
            else if (bw <= 15600)  ifconf.bandwidth = BW_15K6HZ;
            else if (bw <= 31200)  ifconf.bandwidth = BW_31K2HZ;
            else if (bw <= 62500)  ifconf.bandwidth = BW_62K5HZ;
            else if (bw <= 125000) ifconf.bandwidth = BW_125KHZ;
            else if (bw <= 250000) ifconf.bandwidth = BW_250KHZ;
            else if (bw <= 500000) ifconf.bandwidth = BW_500KHZ;
            else ifconf.bandwidth = BW_UNDEFINED;

            ESP_LOGI(TAG, "INFO: FSK channel> radio %i, IF %i Hz, %u Hz bw, %u bps datarate", ifconf.rf_chain, ifconf.freq_hz, bw, ifconf.datarate);
        }
        if (lgw_rxif_setconf(9, ifconf) != LGW_HAL_SUCCESS) {
            ESP_LOGE(TAG, "ERROR: invalid configuration for FSK channel");
            return -1;
        }
    }
    json_value_free(root_val);

    return 0;
}

static int parse_gateway_configuration(const char * conf_file) {
    const char conf_obj_name[] = "gateway_conf";
    JSON_Value *root_val;
    JSON_Object *conf_obj = NULL;
    JSON_Value *val = NULL; /* needed to detect the absence of some fields */
    const char *str; /* pointer to sub-strings in the JSON data */

    /* try to parse JSON */
    root_val = json_parse_file_with_comments(conf_file);
    if (root_val == NULL) {
        ESP_LOGE(TAG, "ERROR: %s is not a valid JSON file", conf_file);
        esp_restart();
    }

    /* point to the gateway configuration object */
    conf_obj = json_object_get_object(json_value_get_object(root_val), conf_obj_name);
    if (conf_obj == NULL) {
        ESP_LOGI(TAG, "INFO: %s does not contain a JSON object named %s", conf_file, conf_obj_name);
        return -1;
    } else {
        ESP_LOGI(TAG, "INFO: %s does contain a JSON object named %s, parsing gateway parameters", conf_file, conf_obj_name);
    }

    /* gateway unique identifier (aka MAC address) (optional) */
    /*
    str = json_object_get_string(conf_obj, "gateway_ID");
    if (str != NULL) {
        sscanf(str, "%llx", &ull);
        lgwm = ull;
        ESP_LOGI(TAG, "INFO: gateway MAC address is configured to %016llX", ull);
    }
    */

    /* server hostname or IP address (optional) */
    str = json_object_get_string(conf_obj, "server_address");
    if (str != NULL) {
        strncpy(serv_addr, str, sizeof serv_addr);
        ESP_LOGI(TAG, "INFO: server hostname or IP address is configured to \"%s\"", serv_addr);
    }

    /* get up and down ports (optional) */
    val = json_object_get_value(conf_obj, "serv_port_up");
    if (val != NULL) {
        snprintf(serv_port_up, sizeof serv_port_up, "%u", (uint16_t)json_value_get_number(val));
        ESP_LOGI(TAG, "INFO: upstream port is configured to \"%s\"", serv_port_up);
    }
    val = json_object_get_value(conf_obj, "serv_port_down");
    if (val != NULL) {
        snprintf(serv_port_down, sizeof serv_port_down, "%u", (uint16_t)json_value_get_number(val));
        ESP_LOGI(TAG, "INFO: downstream port is configured to \"%s\"", serv_port_down);
    }

    /* get keep-alive interval (in seconds) for downstream (optional) */
    val = json_object_get_value(conf_obj, "keepalive_interval");
    if (val != NULL) {
        keepalive_time = (int)json_value_get_number(val);
        ESP_LOGI(TAG, "INFO: downstream keep-alive interval is configured to %u seconds", keepalive_time);
    }

    /* get interval (in seconds) for statistics display (optional) */
    val = json_object_get_value(conf_obj, "stat_interval");
    if (val != NULL) {
        stat_interval = (unsigned)json_value_get_number(val);
        ESP_LOGI(TAG, "INFO: statistics display interval is configured to %u seconds", stat_interval);
    }

    /* get time-out value (in ms) for upstream datagrams (optional) */
    val = json_object_get_value(conf_obj, "push_timeout_ms");
    if (val != NULL) {
        push_timeout_half.tv_usec = 500 * (long int)json_value_get_number(val);
        ESP_LOGI(TAG, "INFO: upstream PUSH_DATA time-out is configured to %u ms", (unsigned)(push_timeout_half.tv_usec / 500));
    }

    /* packet filtering parameters */
    val = json_object_get_value(conf_obj, "forward_crc_valid");
    if (json_value_get_type(val) == JSONBoolean) {
        fwd_valid_pkt = (bool)json_value_get_boolean(val);
    }
    ESP_LOGI(TAG, "INFO: packets received with a valid CRC will%s be forwarded", (fwd_valid_pkt ? "" : " NOT"));
    val = json_object_get_value(conf_obj, "forward_crc_error");
    if (json_value_get_type(val) == JSONBoolean) {
        fwd_error_pkt = (bool)json_value_get_boolean(val);
    }
    ESP_LOGI(TAG, "INFO: packets received with a CRC error will%s be forwarded", (fwd_error_pkt ? "" : " NOT"));
    val = json_object_get_value(conf_obj, "forward_crc_disabled");
    if (json_value_get_type(val) == JSONBoolean) {
        fwd_nocrc_pkt = (bool)json_value_get_boolean(val);
    }
    ESP_LOGI(TAG, "INFO: packets received with no CRC will%s be forwarded", (fwd_nocrc_pkt ? "" : " NOT"));


/* GPS module TTY path (optional) */
/*    str = json_object_get_string(conf_obj, "gps_tty_path");
    if (str != NULL) {
        strncpy(gps_tty_path, str, sizeof gps_tty_path);
        ESP_LOGI(TAG, "INFO: GPS serial port path is configured to \"%s\"", gps_tty_path);
    }

*/
    /* get reference coordinates */
    val = json_object_get_value(conf_obj, "ref_latitude");
    if (val != NULL) {
        reference_coord.lat = (double)json_value_get_number(val);
        ESP_LOGI(TAG, "INFO: Reference latitude is configured to %f deg", reference_coord.lat);
    }
    val = json_object_get_value(conf_obj, "ref_longitude");
    if (val != NULL) {
        reference_coord.lon = (double)json_value_get_number(val);
        ESP_LOGI(TAG, "INFO: Reference longitude is configured to %f deg", reference_coord.lon);
    }
    val = json_object_get_value(conf_obj, "ref_altitude");
    if (val != NULL) {
        reference_coord.alt = (short)json_value_get_number(val);
        ESP_LOGI(TAG, "INFO: Reference altitude is configured to %i meters", reference_coord.alt);
    }

    /* Gateway GPS coordinates hardcoding (aka. faking) option */
    val = json_object_get_value(conf_obj, "fake_gps");
    if (json_value_get_type(val) == JSONBoolean) {
        gps_fake_enable = (bool)json_value_get_boolean(val);
        if (gps_fake_enable == true) {
            ESP_LOGI(TAG, "INFO: fake GPS is enabled");
        } else {
            ESP_LOGI(TAG, "INFO: fake GPS is disabled");
        }
    }

    /* Beacon signal period (optional) */
    val = json_object_get_value(conf_obj, "beacon_period");
    if (val != NULL) {
        beacon_period = (uint32_t)json_value_get_number(val);
        if ((beacon_period > 0) && (beacon_period < 6)) {
            ESP_LOGE(TAG, "ERROR: invalid configuration for Beacon period, must be >= 6s");
            return -1;
        } else {
            ESP_LOGI(TAG, "INFO: Beaconing period is configured to %u seconds", beacon_period);
        }
    }

    /* Beacon TX frequency (optional) */
    val = json_object_get_value(conf_obj, "beacon_freq_hz");
    if (val != NULL) {
        beacon_freq_hz = (uint32_t)json_value_get_number(val);
        ESP_LOGI(TAG, "INFO: Beaconing signal will be emitted at %u Hz", beacon_freq_hz);
    }

    /* Number of beacon channels (optional) */
    val = json_object_get_value(conf_obj, "beacon_freq_nb");
    if (val != NULL) {
        beacon_freq_nb = (uint8_t)json_value_get_number(val);
        ESP_LOGI(TAG, "INFO: Beaconing channel number is set to %u", beacon_freq_nb);
    }

    /* Frequency step between beacon channels (optional) */
    val = json_object_get_value(conf_obj, "beacon_freq_step");
    if (val != NULL) {
        beacon_freq_step = (uint32_t)json_value_get_number(val);
        ESP_LOGI(TAG, "INFO: Beaconing channel frequency step is set to %uHz", beacon_freq_step);
    }

    /* Beacon datarate (optional) */
    val = json_object_get_value(conf_obj, "beacon_datarate");
    if (val != NULL) {
        beacon_datarate = (uint8_t)json_value_get_number(val);
        ESP_LOGI(TAG, "INFO: Beaconing datarate is set to SF%d", beacon_datarate);
    }

    /* Beacon modulation bandwidth (optional) */
    val = json_object_get_value(conf_obj, "beacon_bw_hz");
    if (val != NULL) {
        beacon_bw_hz = (uint32_t)json_value_get_number(val);
        ESP_LOGI(TAG, "INFO: Beaconing modulation bandwidth is set to %dHz", beacon_bw_hz);
    }

    /* Beacon TX power (optional) */
    val = json_object_get_value(conf_obj, "beacon_power");
    if (val != NULL) {
        beacon_power = (int8_t)json_value_get_number(val);
        ESP_LOGI(TAG, "INFO: Beaconing TX power is set to %ddBm", beacon_power);
    }

    /* Beacon information descriptor (optional) */
    val = json_object_get_value(conf_obj, "beacon_infodesc");
    if (val != NULL) {
        beacon_infodesc = (uint8_t)json_value_get_number(val);
        ESP_LOGI(TAG, "INFO: Beaconing information descriptor is set to %u", beacon_infodesc);
    }

    /* Auto-quit threshold (optional) */
    val = json_object_get_value(conf_obj, "autoquit_threshold");
    if (val != NULL) {
        autoquit_threshold = (uint32_t)json_value_get_number(val);
        ESP_LOGI(TAG, "INFO: Auto-quit after %u non-acknowledged PULL_DATA", autoquit_threshold);
    }

    /* free JSON parsing data structure */
    json_value_free(root_val);
    return 0;
}

static uint16_t crc16(const uint8_t * data, unsigned size) {
    const uint16_t crc_poly = 0x1021;
    const uint16_t init_val = 0x0000;
    uint16_t x = init_val;
    unsigned i, j;

    if (data == NULL)  {
        return 0;
    }

    for (i=0; i<size; ++i) {
        x ^= (uint16_t)data[i] << 8;
        for (j=0; j<8; ++j) {
            x = (x & 0x8000) ? (x<<1) ^ crc_poly : (x<<1);
        }
    }

    return x;
}

static double difftimeval(struct timeval end, struct timeval beginning) {
    double x;

    x = 1E-6 * (double)(end.tv_usec - beginning.tv_usec);
    x += (double)(end.tv_sec - beginning.tv_sec);

    return x;
}

/*
static double difftimespec(struct timespec end, struct timespec beginning) {
    double x;

    x = 1E-9 * (double)(end.tv_nsec - beginning.tv_nsec);
    x += (double)(end.tv_sec - beginning.tv_sec);

    return x;
}
*/


static int send_tx_ack(uint8_t token_h, uint8_t token_l, enum jit_error_e error) {
    uint8_t buff_ack[64]; /* buffer to give feedback to server */
    int buff_index;

    /* reset buffer */
    memset(&buff_ack, 0, sizeof buff_ack);

    /* Prepare downlink feedback to be sent to server */
    buff_ack[0] = PROTOCOL_VERSION;
    buff_ack[1] = token_h;
    buff_ack[2] = token_l;
    buff_ack[3] = PKT_TX_ACK;
    *(uint32_t *)(buff_ack + 4) = net_mac_h;
    *(uint32_t *)(buff_ack + 8) = net_mac_l;
    buff_index = 12; /* 12-byte header */

    /* Put no JSON string if there is nothing to report */
    if (error != JIT_ERROR_OK) {
        /* start of JSON structure */
        memcpy((void *)(buff_ack + buff_index), (void *)"{\"txpk_ack\":{", 13);
        buff_index += 13;
        /* set downlink error status in JSON structure */
        memcpy((void *)(buff_ack + buff_index), (void *)"\"error\":", 8);
        buff_index += 8;
        switch (error) {
            case JIT_ERROR_FULL:
            case JIT_ERROR_COLLISION_PACKET:
                memcpy((void *)(buff_ack + buff_index), (void *)"\"COLLISION_PACKET\"", 18);
                buff_index += 18;
                /* update stats */
                xSemaphoreTake(mx_meas_dw, portMAX_DELAY);
                meas_nb_tx_rejected_collision_packet += 1;
                xSemaphoreGive(mx_meas_dw);
                break;
            case JIT_ERROR_TOO_LATE:
                memcpy((void *)(buff_ack + buff_index), (void *)"\"TOO_LATE\"", 10);
                buff_index += 10;
                /* update stats */
                xSemaphoreTake(mx_meas_dw, portMAX_DELAY);
                meas_nb_tx_rejected_too_late += 1;
                xSemaphoreGive(mx_meas_dw);
                break;
            case JIT_ERROR_TOO_EARLY:
                memcpy((void *)(buff_ack + buff_index), (void *)"\"TOO_EARLY\"", 11);
                buff_index += 11;
                /* update stats */
                xSemaphoreTake(mx_meas_dw, portMAX_DELAY);
                meas_nb_tx_rejected_too_early += 1;
                xSemaphoreGive(mx_meas_dw);
                break;
            case JIT_ERROR_COLLISION_BEACON:
                memcpy((void *)(buff_ack + buff_index), (void *)"\"COLLISION_BEACON\"", 18);
                buff_index += 18;
                /* update stats */
                xSemaphoreTake(mx_meas_dw, portMAX_DELAY);
                meas_nb_tx_rejected_collision_beacon += 1;
                xSemaphoreGive(mx_meas_dw);
                break;
            case JIT_ERROR_TX_FREQ:
                memcpy((void *)(buff_ack + buff_index), (void *)"\"TX_FREQ\"", 9);
                buff_index += 9;
                break;
            case JIT_ERROR_TX_POWER:
                memcpy((void *)(buff_ack + buff_index), (void *)"\"TX_POWER\"", 10);
                buff_index += 10;
                break;
            case JIT_ERROR_GPS_UNLOCKED:
                memcpy((void *)(buff_ack + buff_index), (void *)"\"GPS_UNLOCKED\"", 14);
                buff_index += 14;
                break;
            default:
                memcpy((void *)(buff_ack + buff_index), (void *)"\"UNKNOWN\"", 9);
                buff_index += 9;
                break;
        }
        /* end of JSON structure */
        memcpy((void *)(buff_ack + buff_index), (void *)"}}", 2);
        buff_index += 2;
    }

    buff_ack[buff_index] = 0; /* add string terminator, for safety */

    /* send datagram to server */
    return send(sock_down, (void *)buff_ack, buff_index, 0);
}

static void get_base_mac(uint8_t* mac_buffer)
{
    uint64_t temp_mac = 0;
    if(mac_buffer != NULL)
    {
        if(esp_efuse_mac_get_default(mac_buffer) == ESP_OK)
        {

            //int bom_start_idx=2;
            ESP_LOGI(TAG, "SUCCESSFULLY READ BASE_MAC FROM EFUSE!");
            for(int i=0; i<8; i++)
            {
                temp_mac = mac_buffer[i];
                lgwm |= (temp_mac << (7-i)*8);
            }

            ESP_LOGI(TAG, "INFO: Actual gateway MAC address is configured to 0x%016llX", lgwm);
        }
        else
        {
            ESP_LOGE(TAG, "UNSUCCESSFUL IN READING BASE_MAC FROM EFUSE!");
        }
    }
}

static void obtain_time(void)
{
    ESP_ERROR_CHECK( nvs_flash_init() );
    initialise_wifi();
    // if (ppposInit() == 0) {
	// 	ESP_LOGE("PPPoS EXAMPLE", "ERROR: GSM not initialized, HALTED");
	// 	while (1){
	// 		vTaskDelay(1000 / portTICK_RATE_MS);
	// 	}
	// }

    xEventGroupWaitBits(wifi_event_group, CONNECTED_BIT,
                        false, true, portMAX_DELAY);
    
    initialize_sntp();

    // wait for time to be set
    time_t now = 0;
    struct tm timeinfo = { 0 };
    int retry = 0;
    const int retry_count = 10;
    while(timeinfo.tm_year < (2016 - 1900) && ++retry < retry_count) {
        ESP_LOGI(TAG,  "Waiting for system time to be set... (%d/%d)", retry, retry_count);
        vTaskDelay(2000 / portTICK_PERIOD_MS);
        time(&now);
        localtime_r(&now, &timeinfo);
    }

    //ESP_ERROR_CHECK( esp_wifi_stop() );
}

static void initialize_sntp(void)
{
    ESP_LOGI(TAG,  "Initializing SNTP");
    sntp_setoperatingmode(SNTP_OPMODE_POLL);
    sntp_setservername(0, "pool.ntp.org");
    sntp_init();
}

static void initialise_wifi(void)
{
    tcpip_adapter_init();
    wifi_event_group = xEventGroupCreate();
    ESP_ERROR_CHECK( esp_event_loop_init(event_handler, NULL) );
    wifi_init_config_t cfg = WIFI_INIT_CONFIG_DEFAULT();
    ESP_ERROR_CHECK( esp_wifi_init(&cfg) );
    ESP_ERROR_CHECK( esp_wifi_set_storage(WIFI_STORAGE_RAM) );
    wifi_config_t wifi_config = {
        .sta = {
            .ssid = EXAMPLE_WIFI_SSID,
            .password = EXAMPLE_WIFI_PASS,
        },
    };
    ESP_LOGI(TAG,  "Setting WiFi configuration SSID %s...", wifi_config.sta.ssid);
    ESP_ERROR_CHECK( esp_wifi_set_mode(WIFI_MODE_STA) );
    ESP_ERROR_CHECK( esp_wifi_set_config(ESP_IF_WIFI_STA, &wifi_config) );
    ESP_ERROR_CHECK( esp_wifi_start() );
}

static esp_err_t event_handler(void *ctx, system_event_t *event)
{
    switch(event->event_id) {
    case SYSTEM_EVENT_STA_START:
        ESP_LOGI(WIFI_TAG, "STARTED STATION MODE");
        esp_wifi_connect();
        break;
    case SYSTEM_EVENT_STA_GOT_IP:
        ESP_LOGI(WIFI_TAG, "OBTAINED IP, NOW CONNECTED");
        xEventGroupSetBits(wifi_event_group, CONNECTED_BIT);
        break;
    case SYSTEM_EVENT_STA_DISCONNECTED:
        ESP_LOGI(WIFI_TAG, "[LOST IP ADDRESS...RECONNECTING...");
        /* This is a workaround as ESP32 WiFi libs don't currently
           auto-reassociate. */
        esp_wifi_connect();
        xEventGroupClearBits(wifi_event_group, CONNECTED_BIT);
        break;
    default:
        break;
    }
    return ESP_OK;
}


/* -------------------------------------------------------------------------- */
/* --- MAIN FUNCTION -------------------------------------------------------- */

void app_main()
{
    time_t now;
    struct tm timeinfo;

    //TODO: Do this more cleanly
    /*Enable 3v3 power enable pin */
    gpio_pad_select_gpio(GPIO_NUM_13);
    /* Set the GPIO as a push/pull output */
    gpio_set_direction(GPIO_NUM_13, GPIO_MODE_OUTPUT);
    gpio_set_level(GPIO_NUM_13, 1);

    time(&now);
    localtime_r(&now, &timeinfo);
    // Is time set? If not, tm_year will be (1970 - 1900).
    if (timeinfo.tm_year < (2018 - 1900)) {
        ESP_LOGI(TAG, "Time is not set yet. Getting time over NTP.");
        obtain_time();
        // update 'now' variable with current time
        time(&now);
    }
    char strftime_buf[64];

    //setenv("TZ", "EAT-3", 1);
    tzset();
    localtime_r(&now, &timeinfo);
    strftime(strftime_buf, sizeof(strftime_buf), "%c", &timeinfo);
    ESP_LOGI(TAG, "The current date/time in at UTC is: %s", strftime_buf);

    ESP_LOGI(TAG, "\r");
    ESP_LOGI(TAG, "====MOUNTING SPIFFS====\r");
    vfs_spiffs_register();
    ESP_LOGI(TAG, "\r");
    if (spiffs_is_mounted)
    {
        mx_stat_rep = xSemaphoreCreateMutex();
        mx_timeref = xSemaphoreCreateMutex();
        mx_meas_up = xSemaphoreCreateMutex();
        mx_meas_dw = xSemaphoreCreateMutex();
        mx_meas_gps = xSemaphoreCreateMutex();
        mx_stat_rep = xSemaphoreCreateMutex();
        mx_concent = xSemaphoreCreateMutex();
        mx_xcorr = xSemaphoreCreateMutex();
	    mx_jit_queue = xSemaphoreCreateMutex();

        TaskHandle_t xtaskhandle_up = NULL;
        TaskHandle_t xtaskhandle_down = NULL;
        TaskHandle_t xtaskhandle_gps = NULL;
        TaskHandle_t xtaskhandle_valid = NULL;
        TaskHandle_t xtaskhandle_jit = NULL;
        TaskHandle_t xtaskhandle_timersync = NULL;
        TaskHandle_t xtaskhandle_stats = NULL;

        int i; /* loop variable and temporary variable for return value */
        int x;

        /* configuration file related */
        char *global_cfg_path= "/spiffs/global_conf.json"; /* contain global (typ. network-wide) configuration */
        char *local_cfg_path = "/spiffs/local_conf.json"; /* contain node specific configuration, overwrite global parameters for parameters that are defined in both */
        char *debug_cfg_path = "/spiffs/debug_conf.json"; /* if present, all other configuration files are ignored */

        /* network socket creation */
        struct addrinfo hints;
        struct addrinfo *result; /* store result of getaddrinfo */
        struct addrinfo *q; /* pointer to move into *result data */
        char host_name[64];
        char port_name[64];

        /* display version informations */
        ESP_LOGI(TAG, "*** Beacon Packet Forwarder for Lora Gateway ***Version: " VERSION_STRING "");
        ESP_LOGI(TAG, "*** Lora concentrator HAL library version info ***%s***", lgw_version_info());

        /* display host endianness */
        #if __BYTE_ORDER__ == __ORDER_LITTLE_ENDIAN__
            ESP_LOGI(TAG, "INFO: Little endian host");
        #elif __BYTE_ORDER__ == __ORDER_BIG_ENDIAN__
            ESP_LOGI(TAG, "INFO: Big endian host");
        #else
            ESP_LOGI(TAG, "INFO: Host endianness unsknown");
        #endif

        get_base_mac(mac_val);
        FILE* fp=fopen(debug_cfg_path, "r");
        FILE* fp1=fopen(global_cfg_path, "r");
        FILE* fp2=fopen(local_cfg_path, "r");

        /* load configuration files */
        if (fp != NULL) {
            /* if there is a debug conf, parse only the debug conf */
            fclose(fp);
            fclose(fp1);
            fclose(fp2);
            ESP_LOGI(TAG, "INFO: found debug configuration file %s, parsing it", debug_cfg_path);
            ESP_LOGI(TAG, "INFO: other configuration files will be ignored");
            x = parse_SX1301_configuration(debug_cfg_path);
            if (x != 0) {
                esp_restart();
            }
            x = parse_gateway_configuration(debug_cfg_path);
            if (x != 0) {
                esp_restart();
            }
        } else if (fp1 != NULL) {
            /* if there is a global conf, parse it and then try to parse local conf  */
            fclose(fp);
            fclose(fp1);
            ESP_LOGI(TAG, "INFO: found global configuration file %s, parsing it", global_cfg_path);
            x = parse_SX1301_configuration(global_cfg_path);
            if (x != 0) {
                esp_restart();
            }
            x = parse_gateway_configuration(global_cfg_path);
            if (x != 0) {
                esp_restart();
            }
            if (fp2 != NULL) {
                fclose(fp2);
                ESP_LOGI(TAG, "INFO: found local configuration file %s, parsing it", local_cfg_path);
                ESP_LOGI(TAG, "INFO: redefined parameters will overwrite global parameters");
                parse_SX1301_configuration(local_cfg_path);
                parse_gateway_configuration(local_cfg_path);
            }
        } else if (fp2 != NULL) {
            /* if there is only a local conf, parse it and that's all */
            fclose(fp);
            fclose(fp1);
            fclose(fp2);
            ESP_LOGI(TAG, "INFO: found local configuration file %s, parsing it", local_cfg_path);
            x = parse_SX1301_configuration(local_cfg_path);
            if (x != 0) {
                esp_restart();
            }
            x = parse_gateway_configuration(local_cfg_path);
            if (x != 0) {
                esp_restart();
            }
        } else {
            ESP_LOGI(TAG, "ERROR: [main] failed to find any configuration file named %s, %s OR %s", global_cfg_path, local_cfg_path, debug_cfg_path);
            esp_restart();
        }

        /* Start GPS a.s.a.p. if gps_fake is set to false, to allow it to lock */
        
        if(gps_fake_enable == false)
        {
            i = lgw_gps_enable("L80", 0, &gps_tty_dev);
            if (i != LGW_GPS_SUCCESS)
            {
                ESP_LOGW(TAG, "WARNING: [main] impossible to open GPS for sync");
                gps_enabled = false;
                gps_ref_valid = false;
            }
            else
            {
                ESP_LOGI(TAG, "INFO: [main] GPS open for synchronization");
                gps_enabled = true;
                gps_ref_valid = false;
            }
        }

        /* get timezone info */
        tzset();

        /* sanity check on configuration variables */
        // TODO

        /* process some of the configuration variables */
        net_mac_h = htonl((uint32_t)(0xFFFFFFFF & (lgwm>>32)));
        net_mac_l = htonl((uint32_t)(0xFFFFFFFF &  lgwm  ));

        /* prepare hints to open network sockets */
        memset(&hints, 0, sizeof hints);
        hints.ai_family = AF_INET; /* WA: Forcing IPv4 as AF_UNSPEC makes connection on localhost to fail */
        hints.ai_socktype = SOCK_DGRAM;

        /* look for server address w/ upstream port */
        i = getaddrinfo(serv_addr, serv_port_up, &hints, &result);
        if (i != 0) {
            ESP_LOGE(TAG, "ERROR: [up] getaddrinfo on address %s (PORT %s) returned error code %d", serv_addr, serv_port_up, i);
            esp_restart();
        }

        /* try to open socket for upstream traffic */
        for (q=result; q!=NULL; q=q->ai_next) {
            sock_up = socket(q->ai_family, q->ai_socktype, q->ai_protocol);
            if (sock_up == -1) continue; /* try next field */
            else break; /* success, get out of loop */
        }
        if (q == NULL) {
            ESP_LOGE(TAG, "ERROR: [up] failed to open socket to any of server %s addresses (port %s)", serv_addr, serv_port_up);
            i = 1;
            for (q=result; q!=NULL; q=q->ai_next) {
                //getnameinfo(q->ai_addr, q->ai_addrlen, host_name, sizeof host_name, port_name, sizeof port_name, NI_NUMERICHOST);
                ESP_LOGI(TAG, "INFO: [up] result %i host:%s port:%d", i, inet_ntoa(((struct sockaddr_in*)(q->ai_addr))->sin_addr.s_addr), 
                                                                 ntohs(((struct sockaddr_in*)(q->ai_addr))->sin_port));
                ++i;
            }
            esp_restart();
        }

        /* connect so we can send/receive packet with the server only */
        i = connect(sock_up, q->ai_addr, q->ai_addrlen);
        if (i != 0) {
            ESP_LOGE(TAG, "ERROR: [up] connect returned %s", strerror(errno));
            esp_restart();
        }
        freeaddrinfo(result);

        /* look for server address w/ downstream port */
        i = getaddrinfo(serv_addr, serv_port_down, &hints, &result);
        if (i != 0) {
            ESP_LOGE(TAG, "ERROR: [down] getaddrinfo on address %s (port %s) returned error code %d", serv_addr, serv_port_up, i);
            esp_restart();
        }

        /* try to open socket for downstream traffic */
        for (q=result; q!=NULL; q=q->ai_next) {
            sock_down = socket(q->ai_family, q->ai_socktype,q->ai_protocol);
            if (sock_down == -1) continue; /* try next field */
            else break; /* success, get out of loop */
        }
        if (q == NULL) {
            ESP_LOGE(TAG, "ERROR: [down] failed to open socket to any of server %s addresses (port %s)", serv_addr, serv_port_up);
            i = 1;
            for (q=result; q!=NULL; q=q->ai_next) {
                //getnameinfo(q->ai_addr, q->ai_addrlen, host_name, sizeof host_name, port_name, sizeof port_name, NI_NUMERICHOST);
                ESP_LOGI(TAG, "INFO: [down] result %i host:%s service:%d", i, inet_ntoa(((struct sockaddr_in*)(q->ai_addr))->sin_addr.s_addr),
                                                                    ntohs(((struct sockaddr_in*)(q->ai_addr))->sin_port));
                ++i;
            }
            esp_restart();
        }

        /* connect so we can send/receive packet with the server only */
        i = connect(sock_down, q->ai_addr, q->ai_addrlen);
        if (i != 0) {
            ESP_LOGE(TAG, "ERROR: [down] connect returned %s", strerror(errno));
            esp_restart();
        }
        freeaddrinfo(result);

        /* starting the concentrator */
        i = lgw_start(SPI_SPEED);
        if (i == LGW_HAL_SUCCESS) {
            ESP_LOGI(TAG, "INFO: [main] concentrator started, packet can now be received");
        } else {
            ESP_LOGE(TAG, "ERROR: [main] failed to start the concentrator");
            esp_restart();
        }

        /* spawn tasks to manage upstream and downstream */
        xTaskCreate(task_up, "task_up", 1024 * 10, NULL, 1, &xtaskhandle_up);
        if (xtaskhandle_up == NULL) {
            ESP_LOGE(TAG, "ERROR: [main] impossible to create upstream task");
            esp_restart();
        }
        xTaskCreate(task_down, "task_down", 1024 * 10, NULL, 1, &xtaskhandle_down);
        if (xtaskhandle_down == NULL) {
            ESP_LOGE(TAG, "ERROR: [main] impossible to create downstream task");
            esp_restart();
        }
        xTaskCreate(task_jit, "task_jit", 1024 * 10, NULL, 1, &xtaskhandle_jit);
        if (xtaskhandle_jit == NULL) {
            ESP_LOGE(TAG, "ERROR: [main] impossible to create JIT task");
            esp_restart();
        }
        xTaskCreate(task_timersync, "task_timersync", 1024 * 10, NULL, 1, &xtaskhandle_timersync);
        if (xtaskhandle_timersync == NULL) {
            ESP_LOGE(TAG, "ERROR: [main] impossible to create Timer Sync task");
            esp_restart();
        }

        /* spawn thread to manage GPS */
        if (gps_fake_enable == false) {
            xTaskCreate(task_gps, "task_gps", 1024 * 10, NULL, 1 , &xtaskhandle_gps);
            if (xtaskhandle_gps == NULL) {
                ESP_LOGE(TAG, "ERROR: [main] impossible to create GPS task");
                esp_restart();
            }
            xTaskCreate(task_valid, "task_valid", 1024 * 2, NULL, 1, &xtaskhandle_valid);
            if (xtaskhandle_valid == NULL) {
                ESP_LOGE(TAG, "ERROR: [main] impossible to create validation task");
                esp_restart();
            }
        }
        xTaskCreate(task_stats, "task_stats", 1024 * 10, NULL, 1, &xtaskhandle_stats);
        if (xtaskhandle_stats == NULL) {
            ESP_LOGE(TAG, "ERROR: [main] impossible to create Statistics task");
            esp_restart();
        }

        ESP_LOGI(TAG, "INFO: Exiting packet forwarder program");
    }
    else
    {
        ESP_LOGI(TAG, "Failed to mount SPIFFS");
        esp_restart();
    }
}

static void task_stats(void* pvparameters)
{
    int i;
    /* variables to get local copies of measurements */
    uint32_t cp_nb_rx_rcv;
    uint32_t cp_nb_rx_ok;
    uint32_t cp_nb_rx_bad;
    uint32_t cp_nb_rx_nocrc;
    uint32_t cp_up_pkt_fwd;
    uint32_t cp_up_network_byte;
    uint32_t cp_up_payload_byte;
    uint32_t cp_up_dgram_sent;
    uint32_t cp_up_ack_rcv;
    uint32_t cp_dw_pull_sent;
    uint32_t cp_dw_ack_rcv;
    uint32_t cp_dw_dgram_rcv;
    uint32_t cp_dw_network_byte;
    uint32_t cp_dw_payload_byte;
    uint32_t cp_nb_tx_ok;
    uint32_t cp_nb_tx_fail;
    uint32_t cp_nb_tx_requested = 0;
    uint32_t cp_nb_tx_rejected_collision_packet = 0;
    uint32_t cp_nb_tx_rejected_collision_beacon = 0;
    uint32_t cp_nb_tx_rejected_too_late = 0;
    uint32_t cp_nb_tx_rejected_too_early = 0;
    uint32_t cp_nb_beacon_queued = 0;
    uint32_t cp_nb_beacon_sent = 0;
    uint32_t cp_nb_beacon_rejected = 0;

    /* GPS coordinates variables */
    bool coord_ok = false;
    struct coord_s cp_gps_coord = {0.0, 0.0, 0};

    /* SX1301 data variables */
    uint32_t trig_tstamp;

    /* statistics variable */
    time_t t;
    char stat_timestamp[24];
    float rx_ok_ratio;
    float rx_bad_ratio;
    float rx_nocrc_ratio;
    float up_ack_ratio;
    float dw_ack_ratio;
    /* main loop task : statistics collection */
    while (1)
    {
        /* wait for next reporting interval */
        wait_ms(1000 * stat_interval);

        /* get timestamp for statistics */
        t = time(NULL);
        strftime(stat_timestamp, sizeof stat_timestamp, "%F %T %Z", gmtime(&t));

        /* access upstream statistics, copy and reset them */
        xSemaphoreTake(mx_meas_up, portMAX_DELAY);
        cp_nb_rx_rcv       = meas_nb_rx_rcv;
        cp_nb_rx_ok        = meas_nb_rx_ok;
        cp_nb_rx_bad       = meas_nb_rx_bad;
        cp_nb_rx_nocrc     = meas_nb_rx_nocrc;
        cp_up_pkt_fwd      = meas_up_pkt_fwd;
        cp_up_network_byte = meas_up_network_byte;
        cp_up_payload_byte = meas_up_payload_byte;
        cp_up_dgram_sent   = meas_up_dgram_sent;
        cp_up_ack_rcv      = meas_up_ack_rcv;
        meas_nb_rx_rcv = 0;
        meas_nb_rx_ok = 0;
        meas_nb_rx_bad = 0;
        meas_nb_rx_nocrc = 0;
        meas_up_pkt_fwd = 0;
        meas_up_network_byte = 0;
        meas_up_payload_byte = 0;
        meas_up_dgram_sent = 0;
        meas_up_ack_rcv = 0;
        xSemaphoreGive(mx_meas_up);
        if (cp_nb_rx_rcv > 0) {
            rx_ok_ratio = (float)cp_nb_rx_ok / (float)cp_nb_rx_rcv;
            rx_bad_ratio = (float)cp_nb_rx_bad / (float)cp_nb_rx_rcv;
            rx_nocrc_ratio = (float)cp_nb_rx_nocrc / (float)cp_nb_rx_rcv;
        } else {
            rx_ok_ratio = 0.0;
            rx_bad_ratio = 0.0;
            rx_nocrc_ratio = 0.0;
        }
        if (cp_up_dgram_sent > 0) {
            up_ack_ratio = (float)cp_up_ack_rcv / (float)cp_up_dgram_sent;
        } else {
            up_ack_ratio = 0.0;
        }

        /* access downstream statistics, copy and reset them */
        xSemaphoreTake(mx_meas_dw, portMAX_DELAY);
        cp_dw_pull_sent    =  meas_dw_pull_sent;
        cp_dw_ack_rcv      =  meas_dw_ack_rcv;
        cp_dw_dgram_rcv    =  meas_dw_dgram_rcv;
        cp_dw_network_byte =  meas_dw_network_byte;
        cp_dw_payload_byte =  meas_dw_payload_byte;
        cp_nb_tx_ok        =  meas_nb_tx_ok;
        cp_nb_tx_fail      =  meas_nb_tx_fail;
        cp_nb_tx_requested                 +=  meas_nb_tx_requested;
        cp_nb_tx_rejected_collision_packet +=  meas_nb_tx_rejected_collision_packet;
        cp_nb_tx_rejected_collision_beacon +=  meas_nb_tx_rejected_collision_beacon;
        cp_nb_tx_rejected_too_late         +=  meas_nb_tx_rejected_too_late;
        cp_nb_tx_rejected_too_early        +=  meas_nb_tx_rejected_too_early;
        cp_nb_beacon_queued   +=  meas_nb_beacon_queued;
        cp_nb_beacon_sent     +=  meas_nb_beacon_sent;
        cp_nb_beacon_rejected +=  meas_nb_beacon_rejected;
        meas_dw_pull_sent = 0;
        meas_dw_ack_rcv = 0;
        meas_dw_dgram_rcv = 0;
        meas_dw_network_byte = 0;
        meas_dw_payload_byte = 0;
        meas_nb_tx_ok = 0;
        meas_nb_tx_fail = 0;
        meas_nb_tx_requested = 0;
        meas_nb_tx_rejected_collision_packet = 0;
        meas_nb_tx_rejected_collision_beacon = 0;
        meas_nb_tx_rejected_too_late = 0;
        meas_nb_tx_rejected_too_early = 0;
        meas_nb_beacon_queued = 0;
        meas_nb_beacon_sent = 0;
        meas_nb_beacon_rejected = 0;
        xSemaphoreGive(mx_meas_dw);
        if (cp_dw_pull_sent > 0) {
            dw_ack_ratio = (float)cp_dw_ack_rcv / (float)cp_dw_pull_sent;
        } else {
            dw_ack_ratio = 0.0;
        }

        /* access GPS statistics, copy them */
        if (gps_enabled == true) {
            xSemaphoreTake(mx_meas_gps, portMAX_DELAY);
            coord_ok = gps_coord_valid;
            cp_gps_coord = meas_gps_coord;
            xSemaphoreGive(mx_meas_gps);
        }

        /* overwrite with reference coordinates if function is enabled */
        if (gps_fake_enable == true) {
            xSemaphoreTake(mx_meas_gps, portMAX_DELAY);
            cp_gps_coord = reference_coord;
            xSemaphoreGive(mx_meas_gps);
        }

        /* display a report */
        ESP_LOGI(TAG, "##### %s #####", stat_timestamp);
        ESP_LOGI(TAG, "### [UPSTREAM] ###");
        ESP_LOGI(TAG, "# RF packets received by concentrator: %u", cp_nb_rx_rcv);
        ESP_LOGI(TAG, "# CRC_OK: %.2f%%, CRC_FAIL: %.2f%%, NO_CRC: %.2f%%", 100.0 * rx_ok_ratio, 100.0 * rx_bad_ratio, 100.0 * rx_nocrc_ratio);
        ESP_LOGI(TAG, "# RF packets forwarded: %u (%u bytes)", cp_up_pkt_fwd, cp_up_payload_byte);
        ESP_LOGI(TAG, "# PUSH_DATA datagrams sent: %u (%u bytes)", cp_up_dgram_sent, cp_up_network_byte);
        ESP_LOGI(TAG, "# PUSH_DATA acknowledged: %.2f%%", 100.0 * up_ack_ratio);
        ESP_LOGI(TAG, "### [DOWNSTREAM] ###");
        ESP_LOGI(TAG, "# PULL_DATA sent: %u (%.2f%% acknowledged)", cp_dw_pull_sent, 100.0 * dw_ack_ratio);
        ESP_LOGI(TAG, "# PULL_RESP(onse) datagrams received: %u (%u bytes)", cp_dw_dgram_rcv, cp_dw_network_byte);
        ESP_LOGI(TAG, "# RF packets sent to concentrator: %u (%u bytes)", (cp_nb_tx_ok+cp_nb_tx_fail), cp_dw_payload_byte);
        ESP_LOGI(TAG, "# TX errors: %u", cp_nb_tx_fail);
        if (cp_nb_tx_requested != 0 )
        {
            ESP_LOGI(TAG, "# TX rejected (collision packet): %.2f%% (req:%u, rej:%u)", 100.0 * cp_nb_tx_rejected_collision_packet / cp_nb_tx_requested, cp_nb_tx_requested, cp_nb_tx_rejected_collision_packet);
            ESP_LOGI(TAG, "# TX rejected (collision beacon): %.2f%% (req:%u, rej:%u)", 100.0 * cp_nb_tx_rejected_collision_beacon / cp_nb_tx_requested, cp_nb_tx_requested, cp_nb_tx_rejected_collision_beacon);
            ESP_LOGI(TAG, "# TX rejected (too late): %.2f%% (req:%u, rej:%u)", 100.0 * cp_nb_tx_rejected_too_late / cp_nb_tx_requested, cp_nb_tx_requested, cp_nb_tx_rejected_too_late);
            ESP_LOGI(TAG, "# TX rejected (too early): %.2f%% (req:%u, rej:%u)", 100.0 * cp_nb_tx_rejected_too_early / cp_nb_tx_requested, cp_nb_tx_requested, cp_nb_tx_rejected_too_early);
        }
        ESP_LOGI(TAG, "# BEACON queued: %u", cp_nb_beacon_queued);
        ESP_LOGI(TAG, "# BEACON sent so far: %u", cp_nb_beacon_sent);
        ESP_LOGI(TAG, "# BEACON rejected: %u", cp_nb_beacon_rejected);
        ESP_LOGI(TAG, "### [JIT] ###");
        /* get timestamp captured on PPM pulse  */
        xSemaphoreTake(mx_concent, portMAX_DELAY);
        i = lgw_get_trigcnt(&trig_tstamp);
        xSemaphoreGive(mx_concent);
        if (i != LGW_HAL_SUCCESS) {
            ESP_LOGI(TAG, "# SX1301 time (PPS): unknown");
        } else {
            ESP_LOGI(TAG, "# SX1301 time (PPS): %u", trig_tstamp);
        }
        jit_print_queue (&jit_queue, false, DEBUG_LOG);
        ESP_LOGI(TAG, "### [GPS] ###");
        if (gps_enabled == true) {
            /* no need for mutex, display is not critical */
            if (gps_ref_valid == true) {
                ESP_LOGI(TAG, "# Valid time reference (age: %li sec)", (long)difftime(time(NULL), time_reference_gps.systime));
            } else {
                ESP_LOGI(TAG, "# Invalid time reference (age: %li sec)", (long)difftime(time(NULL), time_reference_gps.systime));
            }
            if (coord_ok == true) {
                ESP_LOGI(TAG, "# GPS coordinates: latitude %.5f, longitude %.5f, altitude %i m", cp_gps_coord.lat, cp_gps_coord.lon, cp_gps_coord.alt);
            } else {
                ESP_LOGI(TAG, "# no valid GPS coordinates available yet");
            }
        } else if (gps_fake_enable == true) {
            ESP_LOGI(TAG, "# GPS *FAKE* coordinates: latitude %.5f, longitude %.5f, altitude %i m", cp_gps_coord.lat, cp_gps_coord.lon, cp_gps_coord.alt);
        } else {
            ESP_LOGI(TAG, "# GPS sync is disabled");
        }
        ESP_LOGI(TAG, "##### END #####");

        /* generate a JSON report (will be sent to server by upstream thread) */
        xSemaphoreTake(mx_stat_rep, portMAX_DELAY);
        if (((gps_enabled == true) && (coord_ok == true)) || (gps_fake_enable == true)) {
            snprintf(status_report, STATUS_SIZE, "\"stat\":{\"time\":\"%s\",\"lati\":%.5f,\"long\":%.5f,\"alti\":%i,\"rxnb\":%u,\"rxok\":%u,\"rxfw\":%u,\"ackr\":%.1f,\"dwnb\":%u,\"txnb\":%u}", stat_timestamp, cp_gps_coord.lat, cp_gps_coord.lon, cp_gps_coord.alt, cp_nb_rx_rcv, cp_nb_rx_ok, cp_up_pkt_fwd, 100.0 * up_ack_ratio, cp_dw_dgram_rcv, cp_nb_tx_ok);
        } else {
            snprintf(status_report, STATUS_SIZE, "\"stat\":{\"time\":\"%s\",\"rxnb\":%u,\"rxok\":%u,\"rxfw\":%u,\"ackr\":%.1f,\"dwnb\":%u,\"txnb\":%u}", stat_timestamp, cp_nb_rx_rcv, cp_nb_rx_ok, cp_up_pkt_fwd, 100.0 * up_ack_ratio, cp_dw_dgram_rcv, cp_nb_tx_ok);
        }
        report_ready = true;
        xSemaphoreGive(mx_stat_rep);
        }
}
/* -------------------------------------------------------------------------- */
/* --- THREAD 1: RECEIVING PACKETS AND FORWARDING THEM ---------------------- */

static void task_up(void *pvParameters) {
    int i, j; /* loop variables */
    unsigned pkt_in_dgram; /* nb on Lora packet in the current datagram */

    /* allocate memory for packet fetching and processing */
    struct lgw_pkt_rx_s rxpkt[NB_PKT_MAX]; /* array containing inbound packets + metadata */
    struct lgw_pkt_rx_s *p; /* pointer on a RX packet */
    int nb_pkt;

    /* local copy of GPS time reference */
    bool ref_ok = false; /* determine if GPS time reference must be used or not */
    struct tref local_ref; /* time reference used for UTC <-> timestamp conversion */

    /* data buffers */
    uint8_t buff_up[TX_BUFF_SIZE]; /* buffer to compose the upstream packet */
    int buff_index;
    uint8_t buff_ack[32]; /* buffer to receive acknowledges */

    /* protocol variables */
    uint8_t token_h; /* random token for acknowledgement matching */
    uint8_t token_l; /* random token for acknowledgement matching */

    /* ping measurement variables */
    //struct timespec send_time;
    //struct timespec recv_time;

    struct timeval send_time;
    struct timeval recv_time;

    /* GPS synchronization variables */
    struct timespec pkt_utc_time;
    //struct timeval pkt_utc_time;
    struct tm * x; /* broken-up UTC time */
    //struct timeval pkt_gps_time;
    struct timespec pkt_gps_time;
    uint64_t pkt_gps_time_ms;

    /* report management variable */
    bool send_report = false;

    /* mote info variables */
    uint32_t mote_addr = 0;
    uint16_t mote_fcnt = 0;

    /* set upstream socket RX timeout */
    i = setsockopt(sock_up, SOL_SOCKET, SO_RCVTIMEO, (void *)&push_timeout_half, sizeof push_timeout_half);
    if (i != 0) {
        ESP_LOGE(TAG, "ERROR: [up] setsockopt returned %s", strerror(errno));
        return;
    }

    /* pre-fill the data buffer with fixed fields */
    buff_up[0] = PROTOCOL_VERSION;
    buff_up[3] = PKT_PUSH_DATA;
    *(uint32_t *)(buff_up + 4) = net_mac_h;
    *(uint32_t *)(buff_up + 8) = net_mac_l;

    while (1) {

        /* fetch packets */
        xSemaphoreTake(mx_concent, portMAX_DELAY);
        nb_pkt = lgw_receive(NB_PKT_MAX, rxpkt);
        xSemaphoreGive(mx_concent);
        if (nb_pkt == LGW_HAL_ERROR) {
            ESP_LOGE(TAG, "ERROR: [up] failed packet fetch, exiting");
            return;
        }

        /* check if there are status report to send */
        send_report = report_ready; /* copy the variable so it doesn't change mid-function */
        /* no mutex, we're only reading */

        /* wait a short time if no packets, nor status report */
        if ((nb_pkt == 0) && (send_report == false)) {
            wait_ms(FETCH_SLEEP_MS);
            continue;
        }

        /* get a copy of GPS time reference (avoid 1 mutex per packet) */
        if ((nb_pkt > 0) && (gps_enabled == true)) {
            xSemaphoreTake(mx_timeref, portMAX_DELAY);
            ref_ok = gps_ref_valid;
            local_ref = time_reference_gps;
            xSemaphoreGive(mx_timeref);
        } else {
            ref_ok = false;
        }

        /* start composing datagram with the header */
        token_h = (uint8_t)rand(); /* random token */
        token_l = (uint8_t)rand(); /* random token */
        buff_up[1] = token_h;
        buff_up[2] = token_l;
        buff_index = 12; /* 12-byte header */

        /* start of JSON structure */
        memcpy((void *)(buff_up + buff_index), (void *)"{\"rxpk\":[", 9);
        buff_index += 9;

        /* serialize Lora packets metadata and payload */
        pkt_in_dgram = 0;
        for (i=0; i < nb_pkt; ++i) {
            p = &rxpkt[i];

            /* Get mote information from current packet (addr, fcnt) */
            /* FHDR - DevAddr */
            mote_addr  = p->payload[1];
            mote_addr |= p->payload[2] << 8;
            mote_addr |= p->payload[3] << 16;
            mote_addr |= p->payload[4] << 24;
            /* FHDR - FCnt */
            mote_fcnt  = p->payload[6];
            mote_fcnt |= p->payload[7] << 8;

            /* basic packet filtering */
            xSemaphoreTake(mx_meas_up, portMAX_DELAY);
            meas_nb_rx_rcv += 1;
            switch(p->status) {
                case STAT_CRC_OK:
                    meas_nb_rx_ok += 1;
                    ESP_LOGI(TAG,  "INFO: Received pkt from mote: %08X (fcnt=%u)", mote_addr, mote_fcnt );
                    if (!fwd_valid_pkt) {
                        xSemaphoreGive(mx_meas_up);
                        continue; /* skip that packet */
                    }
                    break;
                case STAT_CRC_BAD:
                    meas_nb_rx_bad += 1;
                    if (!fwd_error_pkt) {
                        xSemaphoreGive(mx_meas_up);
                        continue; /* skip that packet */
                    }
                    break;
                case STAT_NO_CRC:
                    meas_nb_rx_nocrc += 1;
                    if (!fwd_nocrc_pkt) {
                        xSemaphoreGive(mx_meas_up);
                        continue; /* skip that packet */
                    }
                    break;
                default:
                    ESP_LOGW(TAG, "WARNING: [up] received packet with unknown status %u (size %u, modulation %u, BW %u, DR %u, RSSI %.1f)", p->status, p->size, p->modulation, p->bandwidth, p->datarate, p->rssi);
                    xSemaphoreGive(mx_meas_up);
                    continue; /* skip that packet */
                    // esp_restart();
            }
            meas_up_pkt_fwd += 1;
            meas_up_payload_byte += p->size;
            xSemaphoreGive(mx_meas_up);

            /* Start of packet, add inter-packet separator if necessary */
            if (pkt_in_dgram == 0) {
                buff_up[buff_index] = '{';
                ++buff_index;
            } else {
                buff_up[buff_index] = ',';
                buff_up[buff_index+1] = '{';
                buff_index += 2;
            }

            /* RAW timestamp, 8-17 useful chars */
            j = snprintf((char *)(buff_up + buff_index), TX_BUFF_SIZE-buff_index, "\"tmst\":%u", p->count_us);
            if (j > 0) {
                buff_index += j;
            } else {
                ESP_LOGE(TAG, "ERROR: [up] snprintf failed line %u", (__LINE__ - 4));
                return;
            }

            /* Packet RX time (GPS based), 37 useful chars */
            if (ref_ok == true) {
                /* convert packet timestamp to UTC absolute time */
                j = lgw_cnt2utc(local_ref, p->count_us, &pkt_utc_time);
                if (j == LGW_GPS_SUCCESS) {
                    /* split the UNIX timestamp to its calendar components */
                    x = gmtime(&(pkt_utc_time.tv_sec));
                    j = snprintf((char *)(buff_up + buff_index), TX_BUFF_SIZE-buff_index, ",\"time\":\"%04i-%02i-%02iT%02i:%02i:%02i.%06liZ\"", (x->tm_year)+1900, (x->tm_mon)+1, x->tm_mday, x->tm_hour, x->tm_min, x->tm_sec, (pkt_utc_time.tv_nsec)/1000); /* ISO 8601 format */
                    if (j > 0) {
                        buff_index += j;
                    } else {
                        ESP_LOGE(TAG, "ERROR: [up] snprintf failed line %u", (__LINE__ - 4));
                        return;
                    }
                }
                /* convert packet timestamp to GPS absolute time */
                j = lgw_cnt2gps(local_ref, p->count_us, &pkt_gps_time);
                if (j == LGW_GPS_SUCCESS) {
                    pkt_gps_time_ms = pkt_gps_time.tv_sec * 1E3 + pkt_gps_time.tv_nsec / 1E3;
                    j = snprintf((char *)(buff_up + buff_index), TX_BUFF_SIZE-buff_index, ",\"tmms\":%llu",
                                    pkt_gps_time_ms); /* GPS time in milliseconds since 06.Jan.1980 */
                    if (j > 0) {
                        buff_index += j;
                    } else {
                        ESP_LOGE(TAG, "ERROR: [up] snprintf failed line %u", (__LINE__ - 4));
                        return;
                    }
                }
            }

            /* Packet concentrator channel, RF chain & RX frequency, 34-36 useful chars */
            j = snprintf((char *)(buff_up + buff_index), TX_BUFF_SIZE-buff_index, ",\"chan\":%1u,\"rfch\":%1u,\"freq\":%.6lf", p->if_chain, p->rf_chain, ((double)p->freq_hz / 1e6));
            if (j > 0) {
                buff_index += j;
            } else {
                ESP_LOGE(TAG, "ERROR: [up] snprintf failed line %u", (__LINE__ - 4));
                return;
            }

            /* Packet status, 9-10 useful chars */
            switch (p->status) {
                case STAT_CRC_OK:
                    memcpy((void *)(buff_up + buff_index), (void *)",\"stat\":1", 9);
                    buff_index += 9;
                    break;
                case STAT_CRC_BAD:
                    memcpy((void *)(buff_up + buff_index), (void *)",\"stat\":-1", 10);
                    buff_index += 10;
                    break;
                case STAT_NO_CRC:
                    memcpy((void *)(buff_up + buff_index), (void *)",\"stat\":0", 9);
                    buff_index += 9;
                    break;
                default:
                    ESP_LOGI(TAG, "ERROR: [up] received packet with unknown status");
                    memcpy((void *)(buff_up + buff_index), (void *)",\"stat\":?", 9);
                    buff_index += 9;
                    return;
            }

            /* Packet modulation, 13-14 useful chars */
            if (p->modulation == MOD_LORA) {
                memcpy((void *)(buff_up + buff_index), (void *)",\"modu\":\"LORA\"", 14);
                buff_index += 14;

                /* Lora datarate & bandwidth, 16-19 useful chars */
                switch (p->datarate) {
                    case DR_LORA_SF7:
                        memcpy((void *)(buff_up + buff_index), (void *)",\"datr\":\"SF7", 12);
                        buff_index += 12;
                        break;
                    case DR_LORA_SF8:
                        memcpy((void *)(buff_up + buff_index), (void *)",\"datr\":\"SF8", 12);
                        buff_index += 12;
                        break;
                    case DR_LORA_SF9:
                        memcpy((void *)(buff_up + buff_index), (void *)",\"datr\":\"SF9", 12);
                        buff_index += 12;
                        break;
                    case DR_LORA_SF10:
                        memcpy((void *)(buff_up + buff_index), (void *)",\"datr\":\"SF10", 13);
                        buff_index += 13;
                        break;
                    case DR_LORA_SF11:
                        memcpy((void *)(buff_up + buff_index), (void *)",\"datr\":\"SF11", 13);
                        buff_index += 13;
                        break;
                    case DR_LORA_SF12:
                        memcpy((void *)(buff_up + buff_index), (void *)",\"datr\":\"SF12", 13);
                        buff_index += 13;
                        break;
                    default:
                        ESP_LOGE(TAG, "ERROR: [up] lora packet with unknown datarate");
                        memcpy((void *)(buff_up + buff_index), (void *)",\"datr\":\"SF?", 12);
                        buff_index += 12;
                        return;
                }
                switch (p->bandwidth) {
                    case BW_125KHZ:
                        memcpy((void *)(buff_up + buff_index), (void *)"BW125\"", 6);
                        buff_index += 6;
                        break;
                    case BW_250KHZ:
                        memcpy((void *)(buff_up + buff_index), (void *)"BW250\"", 6);
                        buff_index += 6;
                        break;
                    case BW_500KHZ:
                        memcpy((void *)(buff_up + buff_index), (void *)"BW500\"", 6);
                        buff_index += 6;
                        break;
                    default:
                        ESP_LOGE(TAG, "ERROR: [up] lora packet with unknown bandwidth");
                        memcpy((void *)(buff_up + buff_index), (void *)"BW?\"", 4);
                        buff_index += 4;
                        return;
                }

                /* Packet ECC coding rate, 11-13 useful chars */
                switch (p->coderate) {
                    case CR_LORA_4_5:
                        memcpy((void *)(buff_up + buff_index), (void *)",\"codr\":\"4/5\"", 13);
                        buff_index += 13;
                        break;
                    case CR_LORA_4_6:
                        memcpy((void *)(buff_up + buff_index), (void *)",\"codr\":\"4/6\"", 13);
                        buff_index += 13;
                        break;
                    case CR_LORA_4_7:
                        memcpy((void *)(buff_up + buff_index), (void *)",\"codr\":\"4/7\"", 13);
                        buff_index += 13;
                        break;
                    case CR_LORA_4_8:
                        memcpy((void *)(buff_up + buff_index), (void *)",\"codr\":\"4/8\"", 13);
                        buff_index += 13;
                        break;
                    case 0: /* treat the CR0 case (mostly false sync) */
                        memcpy((void *)(buff_up + buff_index), (void *)",\"codr\":\"OFF\"", 13);
                        buff_index += 13;
                        break;
                    default:
                        ESP_LOGE(TAG, "ERROR: [up] lora packet with unknown coderate");
                        memcpy((void *)(buff_up + buff_index), (void *)",\"codr\":\"?\"", 11);
                        buff_index += 11;
                        return;
                }

                /* Lora SNR, 11-13 useful chars */
                j = snprintf((char *)(buff_up + buff_index), TX_BUFF_SIZE-buff_index, ",\"lsnr\":%.1f", p->snr);
                if (j > 0) {
                    buff_index += j;
                } else {
                    ESP_LOGE(TAG, "ERROR: [up] snprintf failed line %u", (__LINE__ - 4));
                    return;
                }
            } else if (p->modulation == MOD_FSK) {
                memcpy((void *)(buff_up + buff_index), (void *)",\"modu\":\"FSK\"", 13);
                buff_index += 13;

                /* FSK datarate, 11-14 useful chars */
                j = snprintf((char *)(buff_up + buff_index), TX_BUFF_SIZE-buff_index, ",\"datr\":%u", p->datarate);
                if (j > 0) {
                    buff_index += j;
                } else {
                    ESP_LOGE(TAG, "ERROR: [up] snprintf failed line %u", (__LINE__ - 4));
                    return;
                }
            } else {
                ESP_LOGE(TAG, "ERROR: [up] received packet with unknown modulation");
                return;
            }

            /* Packet RSSI, payload size, 18-23 useful chars */
            j = snprintf((char *)(buff_up + buff_index), TX_BUFF_SIZE-buff_index, ",\"rssi\":%.0f,\"size\":%u", p->rssi, p->size);
            if (j > 0) {
                buff_index += j;
            } else {
                ESP_LOGE(TAG, "ERROR: [up] snprintf failed line %u", (__LINE__ - 4));
                return;
            }

            /* Packet base64-encoded payload, 14-350 useful chars */
            memcpy((void *)(buff_up + buff_index), (void *)",\"data\":\"", 9);
            buff_index += 9;
            j = bin_to_b64(p->payload, p->size, (char *)(buff_up + buff_index), 341); /* 255 bytes = 340 chars in b64 + null char */
            if (j>=0) {
                buff_index += j;
            } else {
                ESP_LOGE(TAG, "ERROR: [up] bin_to_b64 failed line %u", (__LINE__ - 5));
                return;
            }
            buff_up[buff_index] = '"';
            ++buff_index;

            /* End of packet serialization */
            buff_up[buff_index] = '}';
            ++buff_index;
            ++pkt_in_dgram;
        }

        /* restart fetch sequence without sending empty JSON if all packets have been filtered out */
        if (pkt_in_dgram == 0) {
            if (send_report == true) {
                /* need to clean up the beginning of the payload */
                buff_index -= 8; /* removes "rxpk":[ */
            } else {
                /* all packet have been filtered out and no report, restart loop */
                continue;
            }
        } else {
            /* end of packet array */
            buff_up[buff_index] = ']';
            ++buff_index;
            /* add separator if needed */
            if (send_report == true) {
                buff_up[buff_index] = ',';
                ++buff_index;
            }
        }

        /* add status report if a new one is available */
        if (send_report == true) {
            xSemaphoreTake(mx_stat_rep, portMAX_DELAY);
            report_ready = false;
            j = snprintf((char *)(buff_up + buff_index), TX_BUFF_SIZE-buff_index, "%s", status_report);
            xSemaphoreGive(mx_stat_rep);
            if (j > 0) {
                buff_index += j;
            } else {
                ESP_LOGE(TAG, "ERROR: [up] snprintf failed line %u", (__LINE__ - 5));
                return;
            }
        }

        /* end of JSON datagram payload */
        buff_up[buff_index] = '}';
        ++buff_index;
        buff_up[buff_index] = 0; /* add string terminator, for safety */

        ESP_LOGI(TAG, "JSON up: %s", (char *)(buff_up + 12)); /* DEBUG: display JSON payload */

        /* send datagram to server */
        send(sock_up, (void *)buff_up, buff_index, 0);
        gettimeofday(&send_time, NULL);
        xSemaphoreTake(mx_meas_up, portMAX_DELAY);
        meas_up_dgram_sent += 1;
        meas_up_network_byte += buff_index;

        /* wait for acknowledge (in 2 times, to catch extra packets) */
        for (i=0; i<2; ++i) {
            j = recv(sock_up, (void *)buff_ack, sizeof buff_ack, 0);
            gettimeofday(&recv_time, NULL);
            if (j == -1) {
                if (errno == EAGAIN) { /* timeout */
                    continue;
                } else { /* server connection error */
                    break;
                }
            } else if ((j < 4) || (buff_ack[0] != PROTOCOL_VERSION) || (buff_ack[3] != PKT_PUSH_ACK)) {
                //ESP_LOGI(TAG, "WARNING: [up] ignored invalid non-ACL packet");
                continue;
            } else if ((buff_ack[1] != token_h) || (buff_ack[2] != token_l)) {
                //ESP_LOGI(TAG, "WARNING: [up] ignored out-of sync ACK packet");
                continue;
            } else {
                //ESP_LOGI(TAG, "INFO: [up] PUSH_ACK received in %i ms", (int)(1000 * difftimespec(recv_time, send_time)));
                meas_up_ack_rcv += 1;
                break;
            }
        }
        xSemaphoreGive(mx_meas_up);
    }
    ESP_LOGI(TAG, "INFO: End of upstream thread");
}

/* -------------------------------------------------------------------------- */
/* --- THREAD 2: POLLING SERVER AND ENQUEUING PACKETS IN JIT QUEUE ---------- */
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
