Kiogora/esp32_lora_gateway/firmware/components/loragw_spi/include/loragw_spi.h

/*
 / _____)             _              | |
( (____  _____ ____ _| |_ _____  ____| |__
 \____ \| ___ |    (_   _) ___ |/ ___)  _ \
 _____) ) ____| | | || |_| ____( (___| | | |
(______/|_____)_|_|_| \__)_____)\____)_| |_|
  (C)2013 Semtech-Cycleo

Description:
    Host specific functions to address the LoRa concentrator registers through a
    SPI interface.
    Single-byte read/write and burst read/write.
    Does not handle pagination.
    Could be used with multiple SPI ports in parallel (explicit file descriptor)

License: Revised BSD License, see LICENSE.TXT file include in the project
Maintainer: Sylvain Miermont
Modified for ESP32 by: Alois Mbutura.
*/


#ifndef _LORAGW_SPI_H
#define _LORAGW_SPI_H

/* -------------------------------------------------------------------------- */
/* --- DEPENDANCIES --------------------------------------------------------- */

#include <stdint.h>        /* C99 types*/
#include "driver/spi_master.h"

#define PIN_NUM_MISO CONFIG_LORA_MISO_PIN
#define PIN_NUM_MOSI CONFIG_LORA_MOSI_PIN
#define PIN_NUM_CLK  CONFIG_LORA_CLK_PIN
#define PIN_NUM_CS   CONFIG_LORA_CS_PIN
#define RESET_PIN    CONFIG_LORA_RESET_PIN

/* -------------------------------------------------------------------------- */
/* --- PUBLIC CONSTANTS ----------------------------------------------------- */

#define LGW_SPI_SUCCESS     0
#define LGW_SPI_ERROR       -1
#define LGW_BURST_CHUNK     1024

#define LGW_SPI_MUX_MODE0   0x0     /* No FPGA */
#define LGW_SPI_MUX_MODE1   0x1     /* FPGA, with spi mux header */

#define LGW_SPI_MUX_TARGET_SX1301   0x0
#define LGW_SPI_MUX_TARGET_FPGA     0x1
#define LGW_SPI_MUX_TARGET_EEPROM   0x2
#define LGW_SPI_MUX_TARGET_SX127X   0x3

/* ---------------------------------- */
/* --- PUBLIC FUNCTIONS PROTOTYPES ---*/

/**
@brief LoRa concentrator SPI setup (configure I/O and peripherals)
@param spi_target_ptr_ptr pointer on a generic pointer to SPI target (implementation dependant)
@param speed SPI communication speed in HZ
@return status of register operation (LGW_SPI_SUCCESS/LGW_SPI_ERROR)
*/

int lgw_spi_open(spi_device_handle_t* spi_target_ptr, long speed);

/**
@brief LoRa concentrator SPI close
@param spi_target_ptr generic pointer to SPI target (implementation dependant)
@return status of register operation (LGW_SPI_SUCCESS/LGW_SPI_ERROR)
*/

int lgw_spi_close(spi_device_handle_t *spi_target_ptr);

/**
@brief LoRa concentrator SPI single-byte write
@param spi_target_ptr generic pointer to SPI target (implementation dependant)
@param address 7-bit register address
@param data data byte to write
@return status of register operation (LGW_SPI_SUCCESS/LGW_SPI_ERROR)
*/
int lgw_spi_w(spi_device_handle_t *spi_target_ptr, uint8_t spi_mux_mode, uint8_t spi_mux_target, uint8_t address, uint8_t data);

/**
@brief LoRa concentrator SPI single-byte read
@param spi_target_ptr generic pointer to SPI target (implementation dependant)
@param address 7-bit register address
@param data data byte to write
@return status of register operation (LGW_SPI_SUCCESS/LGW_SPI_ERROR)
*/
int lgw_spi_r(spi_device_handle_t* spi_target_ptr, uint8_t spi_mux_mode, uint8_t spi_mux_target, uint8_t address, uint8_t *data);

/**
@brief LoRa concentrator SPI burst (multiple-byte) write
@param spi_target_ptr generic pointer to SPI target (implementation dependant)
@param address 7-bit register address
@param data pointer to byte array that will be sent to the LoRa concentrator
@param size size of the transfer, in byte(s)
@return status of register operation (LGW_SPI_SUCCESS/LGW_SPI_ERROR)
*/
int lgw_spi_wb(spi_device_handle_t *spi_target_ptr, uint8_t spi_mux_mode, uint8_t spi_mux_target, uint8_t address, uint8_t *data, uint16_t size);

/**
@brief LoRa concentrator SPI burst (multiple-byte) read
@param spi_target_ptr generic pointer to SPI target (implementation dependant)
@param address 7-bit register address
@param data pointer to byte array that will be written from the LoRa concentrator
@param size size of the transfer, in byte(s)
@return status of register operation (LGW_SPI_SUCCESS/LGW_SPI_ERROR)
*/
int lgw_spi_rb(spi_device_handle_t *spi_target_ptr, uint8_t spi_mux_mode, uint8_t spi_mux_target, uint8_t address, uint8_t *data, uint16_t size);

#endif

/* --- EOF ------------------------------------------------------------------ */
