Kiogora/esp32_lora_gateway/firmware/docs/Quectel_cellular_UG95/Tools/QNavigator_V1.5/QNavigator_V1.5/QCOM_ATC.ini

[1]
Cho=1
CMD=AT+CSQ
HEX=0
Enter=1
Delay=500
Compare=
Errors=
[2]
Cho=1
CMD=AT+CPIN?
HEX=0
Enter=1
Delay=500
Compare=
Errors=
[3]
Cho=1
CMD=AT+CREG?
HEX=0
Enter=1
Delay=500
Compare=
Errors=
[4]
Cho=1
CMD=AT+CGREG?
HEX=0
Enter=1
Delay=500
Compare=
Errors=
[5]
Cho=1
CMD=AT+GSN
HEX=0
Enter=1
Delay=500
Compare=
Errors=
[6]
Cho=1
CMD=AT+QCCID
HEX=0
Enter=1
Delay=500
Compare=
Errors=
[7]
Cho=0
CMD=
HEX=0
Enter=0
Delay=
Compare=
Errors=
[8]
Cho=0
CMD=
HEX=0
Enter=0
Delay=
Compare=
Errors=
[9]
Cho=0
CMD=
HEX=0
Enter=0
Delay=
Compare=
Errors=
[10]
Cho=0
CMD=
HEX=0
Enter=0
Delay=
Compare=
Errors=
[11]
Cho=0
CMD=
HEX=0
Enter=0
Delay=
Compare=
Errors=
[12]
Cho=0
CMD=
HEX=0
Enter=0
Delay=
Compare=
Errors=
[13]
Cho=0
CMD=
HEX=0
Enter=0
Delay=
Compare=
Errors=
[14]
Cho=0
CMD=
HEX=0
Enter=0
Delay=
Compare=
Errors=
[15]
Cho=0
CMD=
HEX=0
Enter=0
Delay=
Compare=
Errors=
[16]
Cho=0
CMD=
HEX=0
Enter=0
Delay=
Compare=
Errors=
[17]
Cho=0
CMD=
HEX=0
Enter=0
Delay=
Compare=
Errors=
[18]
Cho=0
CMD=
HEX=0
Enter=0
Delay=
Compare=
Errors=
[19]
Cho=0
CMD=
HEX=0
Enter=0
Delay=
Compare=
Errors=
[20]
Cho=0
CMD=
HEX=0
Enter=0
Delay=
Compare=
Errors=
