Kiogora/esp32_lora_gateway/firmware/cmdline_tests/cmd_util_tx_continuous.c

/*
  ______                              _
 / _____)             _              | |
( (____  _____ ____ _| |_ _____  ____| |__
 \____ \| ___ |    (_   _) ___ |/ ___)  _ \
 _____) ) ____| | | || |_| ____( (___| | | |
(______/|_____)_|_|_| \__)_____)\____)_| |_|
  (C)2014 Semtech-Cycleo

Description:
    SX1301 tx continuous utility

License: Revised BSD License, see LICENSE.TXT file include in the project
Maintainer: Matthieu Leurent
*/


/* -------------------------------------------------------------------------- */
/* --- DEPENDENCIES --------------------------------------------------------- */

#include <stdint.h>     /* C99 types */
#include <stdbool.h>    /* bool type */
#include <stdio.h>      /* printf fprintf sprintf fopen fputs */
#include <string.h>     /* memset */
#include <stdlib.h>     /* exit codes */
#include "esp_log.h"
#include "esp_console.h"
#include "esp_system.h"
#include "argtable3/argtable3.h"
#include "cmd_decl.h"
#include <stdlib.h>     /* rand */
#include "freertos/FreeRTOS.h"
#include "freertos/task.h"

#include "loragw_hal.h"
#include "loragw_reg.h"
#include "loragw_aux.h"

/* -------------------------------------------------------------------------- */
/* --- MACROS & CONSTANTS --------------------------------------------------- */

#define SPI_SPEED 8000000
#define ARRAY_SIZE(a) (sizeof(a) / sizeof((a)[0]))

#define TX_RF_CHAIN             0    /* TX only supported on radio A */
#define DEFAULT_RSSI_OFFSET     0.0

#define DEFAULT_FREQ_HZ         868e6
#define DEFAULT_DIGITAL_GAIN    0
#define DEFAULT_DAC_GAIN        3
#define DEFAULT_MIXER_GAIN      14
#define DEFAULT_PA_GAIN         3
#define DEFAULT_MODULATION      "LORA"
#define DEFAULT_SF              7
#define DEFAULT_BW_KHZ          125
#define DEFAULT_BR_KBPS         50
#define DEFAULT_FDEV_KHZ        25
#define DEFAULT_BT              2
#define DEFAULT_NOTCH_FREQ      129000U


static struct
{
    struct arg_dbl *f;
    struct arg_int *r;
    struct arg_int *notch;
    struct arg_int *dac;
    struct arg_int *dig;
    struct arg_int *mix;
    struct arg_int *pa;
    struct arg_str *mod;
    struct arg_int *sf;
    struct arg_int *bw;
    struct arg_dbl *br;
    struct arg_int *fdev;
    struct arg_int *bt;
    struct arg_end *end;
}util_tx_continuous_args;

static const char* TAG = "[UTIL_TX_CONTINUOUS]";
/* -------------------------------------------------------------------------- */
/* --- MAIN FUNCTION -------------------------------------------------------- */

int util_tx_continuous(int argc, char **argv)
{
    int i; /* loop and temporary variables */

    unsigned int arg_u;
    float arg_f;
    char* arg_s=NULL;

    /* Application parameters */
    uint32_t freq_hz = DEFAULT_FREQ_HZ;
    uint8_t g_dig = DEFAULT_DIGITAL_GAIN;
    uint8_t g_dac = DEFAULT_DAC_GAIN;
    uint8_t g_mix = DEFAULT_MIXER_GAIN;
    uint8_t g_pa = DEFAULT_PA_GAIN;
    char mod[64] = DEFAULT_MODULATION;
    uint8_t sf = DEFAULT_SF;
    unsigned int bw_khz = DEFAULT_BW_KHZ;
    float br_kbps = DEFAULT_BR_KBPS;
    uint8_t fdev_khz = DEFAULT_FDEV_KHZ;
    uint8_t bt = DEFAULT_BT;
    uint32_t tx_notch_freq = DEFAULT_NOTCH_FREQ;

    int32_t offset_i, offset_q;

    /* RF configuration (TX fail if RF chain is not enabled) */
    enum lgw_radio_type_e radio_type = LGW_RADIO_TYPE_SX1257;
    struct lgw_conf_board_s boardconf;
    struct lgw_conf_rxrf_s rfconf;
    struct lgw_tx_gain_lut_s txlut;
    struct lgw_pkt_tx_s txpkt;

    int nerrors = arg_parse(argc, argv, (void**) &util_tx_continuous_args);
    if (nerrors != 0)
    {
        return 1;
    }

    arg_u=util_tx_continuous_args.f ->dval[0];
    i=util_tx_continuous_args.f ->count;
    if ((i != 1) || (arg_u > 3))
    {
        ESP_LOGE(TAG, "ERROR: argument parsing of --dig argument.n");
        return EXIT_FAILURE;
    }
    else
    {
        g_dig = (uint8_t)arg_u;
    }

    arg_u=util_tx_continuous_args.dac ->ival[0];
    i=util_tx_continuous_args.dac ->count;
    if ((i != 1) || (arg_u > 3)) {
        ESP_LOGE(TAG, "ERROR: argument parsing of --dac argument. ");
        return EXIT_FAILURE;
    }
    else
    {
        g_dac = (uint8_t)arg_u;
    }

    arg_u=util_tx_continuous_args.mix ->ival[0];
    i=util_tx_continuous_args.mix ->count;
    if ((i != 1) || (arg_u > 15))
    {
        ESP_LOGE(TAG, "ERROR: argument parsing of --mix argument. ");
        return EXIT_FAILURE;
    }
    else
    {
        g_mix = (uint8_t)arg_u;
    }

    arg_u=util_tx_continuous_args.pa ->ival[0];
    i=util_tx_continuous_args.pa ->count;
    if ((i != 1) || (arg_u > 3))
    {
        ESP_LOGE(TAG, "ERROR: argument parsing of --pa argument. ");
        return EXIT_FAILURE;
    }
    else
    {
        g_pa = arg_u;
    }

    arg_s=util_tx_continuous_args.mod ->sval[0];
    i=util_tx_continuous_args.mod ->count;
    if ((i != 1) || ((strcmp(arg_s,"LORA") != 0) && (strcmp(arg_s,"FSK") != 0)  && (strcmp(arg_s,"CW") != 0)))
    {
        ESP_LOGE(TAG, "ERROR: argument parsing of --mod argument. ");
        return EXIT_FAILURE;
    }
    else
    {
        sprintf(mod, "%s", arg_s);
    }

    arg_u=util_tx_continuous_args.sf ->ival[0];
    i=util_tx_continuous_args.sf ->count;
    if ((i != 1) || (arg_u < 7) || (arg_u > 12)) {
        ESP_LOGE(TAG, "ERROR: argument parsing of --sf argument. ");
        return EXIT_FAILURE;
    }
    else
    {
        sf = (uint8_t)arg_u;
    }

    arg_u=util_tx_continuous_args.bw ->ival[0];
    i=util_tx_continuous_args.bw ->count;
    if ((i != 1) || ((arg_u != 125) && (arg_u != 250) && (arg_u != 500)))
    {
        ESP_LOGE(TAG, "ERROR: argument parsing of --bw argument. ");
        return EXIT_FAILURE;
    }
    else
    {
        bw_khz = arg_u;
    }

    arg_f=util_tx_continuous_args.br ->dval[0];
    i=util_tx_continuous_args.br ->count;
    if ((i != 1) || (arg_f < 0.5) || (arg_f > 250))
    {
        ESP_LOGE(TAG, "ERROR: argument parsing of --br argument. ");
        return EXIT_FAILURE;
    }
    else
    {
        br_kbps = arg_f;
    }

    arg_u=util_tx_continuous_args.fdev ->ival[0];
    i=util_tx_continuous_args.fdev ->count;
    if ((i != 1) || (arg_u < 1) || (arg_u > 250))
    {
        ESP_LOGE(TAG, "ERROR: argument parsing of --fdev argument. ");
        return EXIT_FAILURE;
    }
    else
    {
        fdev_khz = (uint8_t)arg_u;
    }

    arg_u=util_tx_continuous_args.sf ->ival[0];
    i=util_tx_continuous_args.sf ->count;
    if ((i != 1) || (arg_u > 3))
    {
        ESP_LOGE(TAG, "ERROR: argument parsing of --bt argument. ");
        return EXIT_FAILURE;
    }
    else 
    {
        bt = (uint8_t)arg_u;
    }

    arg_u=util_tx_continuous_args.notch ->ival[0];
    i=util_tx_continuous_args.notch ->count;
    if ((i != 1) || ((arg_u < 126) || (arg_u > 250))) {
        ESP_LOGE(TAG, "ERROR: argument parsing of --notch argument. ");
        return EXIT_FAILURE;
    }
    else
    {
        tx_notch_freq = (uint32_t)arg_u * 1000U;
    }

    arg_f=util_tx_continuous_args.sf ->ival[0];
    i=util_tx_continuous_args.sf ->count;
    if ((i != 1) || (arg_f < 1))
    {
    ESP_LOGE(TAG, "ERROR: argument parsing of -f argument. ");
    return EXIT_FAILURE;
    }
    else
    {
    freq_hz = (uint32_t)((arg_f * 1e6) + 0.5);
    }

    arg_u=util_tx_continuous_args.sf ->ival[0];
    switch (arg_u)
    {
    case 1255:
        radio_type = LGW_RADIO_TYPE_SX1255;
        break;
    case 1257:
        radio_type = LGW_RADIO_TYPE_SX1257;
        break;
    default:
        ESP_LOGE(TAG, "ERROR: argument parsing of -r argument. ");
        return EXIT_FAILURE;
    }

    /* Board config */
    memset(&boardconf, 0, sizeof(boardconf));
    boardconf.lorawan_public = true;
    boardconf.clksrc = 1; /* Radio B is source by default */
    lgw_board_setconf(boardconf);

    /* RF config */
    memset(&rfconf, 0, sizeof(rfconf));
    rfconf.enable = true;
    rfconf.freq_hz = freq_hz;
    rfconf.rssi_offset = DEFAULT_RSSI_OFFSET;
    rfconf.type = radio_type;
    rfconf.tx_enable = true;
    rfconf.tx_notch_freq = tx_notch_freq;
    lgw_rxrf_setconf(TX_RF_CHAIN, rfconf);

    /* Tx gain LUT */
    memset(&txlut, 0, sizeof txlut);
    txlut.size = 1;
    txlut.lut[0].dig_gain = g_dig;
    txlut.lut[0].pa_gain = g_pa;
    txlut.lut[0].dac_gain = g_dac;
    txlut.lut[0].mix_gain = g_mix;
    txlut.lut[0].rf_power = 0;
    lgw_txgain_setconf(&txlut);

    /* Start the concentrator */
    i = lgw_start(SPI_SPEED);
    if (i == LGW_HAL_SUCCESS)
    {
        ESP_LOGI(TAG, "INFO: concentrator started, packet can be sent");
    }
    else
    {
        ESP_LOGE(TAG, "ERROR: failed to start the concentrator");
        return EXIT_FAILURE;
    }

    /* fill-up payload and parameters */
    memset(&txpkt, 0, sizeof(txpkt));
    txpkt.freq_hz = freq_hz;
    txpkt.tx_mode = IMMEDIATE;
    txpkt.rf_chain = TX_RF_CHAIN;
    txpkt.rf_power = 0;
    if (strcmp(mod, "FSK") == 0)
    {
        txpkt.modulation = MOD_FSK;
        txpkt.datarate = br_kbps * 1e3;
    } else {
        txpkt.modulation = MOD_LORA;
        switch (bw_khz) 
        {
            case 125: txpkt.bandwidth = BW_125KHZ; break;
            case 250: txpkt.bandwidth = BW_250KHZ; break;
            case 500: txpkt.bandwidth = BW_500KHZ; break;
            default:
                ESP_LOGE(TAG, "ERROR: invalid 'bw' variable");
                lgw_stop();
                return EXIT_FAILURE;
        }
        switch (sf) 
        {
            case  7: txpkt.datarate = DR_LORA_SF7;  break;
            case  8: txpkt.datarate = DR_LORA_SF8;  break;
            case  9: txpkt.datarate = DR_LORA_SF9;  break;
            case 10: txpkt.datarate = DR_LORA_SF10; break;
            case 11: txpkt.datarate = DR_LORA_SF11; break;
            case 12: txpkt.datarate = DR_LORA_SF12; break;
            default:
                ESP_LOGE(TAG, "ERROR: invalid 'sf' variable");
                lgw_stop();
                return EXIT_FAILURE;
        }
    }
    txpkt.coderate = CR_LORA_4_5;
    txpkt.f_dev = fdev_khz;
    txpkt.preamble = 65535;
    txpkt.invert_pol = false;
    txpkt.no_crc = true;
    txpkt.no_header = true;
    txpkt.size = 1;
    txpkt.payload[0] = 0;

    /* Overwrite settings */
    lgw_reg_w(LGW_TX_MODE, 1); /* Tx continuous */
    lgw_reg_w(LGW_FSK_TX_GAUSSIAN_SELECT_BT, bt);
    if (strcmp(mod, "CW") == 0) {
        /* Enable signal generator with DC */
        lgw_reg_w(LGW_SIG_GEN_FREQ, 0);
        lgw_reg_w(LGW_SIG_GEN_EN, 1);
        lgw_reg_w(LGW_TX_OFFSET_I, 0);
        lgw_reg_w(LGW_TX_OFFSET_Q, 0);
    }

    /* Send packet */
    i = lgw_send(txpkt);

    /* Recap all settings */
    ESP_LOGI(TAG, "SX1301 library version: %s", lgw_version_info());
    if (strcmp(mod, "LORA") == 0) {
        ESP_LOGI(TAG, "Modulation: LORA SF:%d BW:%d kHz", sf, bw_khz);
    }
    else if (strcmp(mod, "FSK") == 0) {
        ESP_LOGI(TAG, "Modulation: FSK BR:%3.3f kbps FDEV:%d kHz BT:%d", br_kbps, fdev_khz, bt);
    }
    else if (strcmp(mod, "CW") == 0) {
        ESP_LOGI(TAG, "Modulation: CW");
    }
    switch(rfconf.type) {
        case LGW_RADIO_TYPE_SX1255:
            ESP_LOGI(TAG, "Radio Type: SX1255");
            break;
        case LGW_RADIO_TYPE_SX1257:
            ESP_LOGI(TAG, "Radio Type: SX1257");
            break;
        default:
            ESP_LOGI(TAG, "ERROR: undefined radio type");
            break;
    }
    ESP_LOGI(TAG, "Frequency: %4.3f MHz", freq_hz/1e6);
    ESP_LOGI(TAG, "TX Gains: Digital:%d DAC:%d Mixer:%d PA:%d", g_dig, g_dac, g_mix, g_pa);
    if (strcmp(mod, "CW") != 0)
    {
        lgw_reg_r(LGW_TX_OFFSET_I, &offset_i);
        lgw_reg_r(LGW_TX_OFFSET_Q, &offset_q);
        ESP_LOGI(TAG, "Calibrated DC offsets: I:%d Q:%d", offset_i, offset_q);
    }

    /* clean up before leaving */
    lgw_stop();

    return 0;
}

void register_tx_continuous()
{
    util_tx_continuous_args.f=arg_dbl1("f", NULL, "<F>", "<float>  Tx RF frequency in MHz [800:1000]");
    util_tx_continuous_args.r=arg_int1("r", NULL, "<R>", "<int>    Radio type (SX1255:1255, SX1257:1257)");
    util_tx_continuous_args.notch=arg_int1(NULL, "notch", "<NOTCH>", "<uint>   Tx notch filter frequency in KhZ [126..250]");
    util_tx_continuous_args.dac=arg_int1(NULL, "dac", "<DAC>", "<uint>   DAC gain trim, [0:3] (0:1, 1:7/8, 2:3/4, 3:1/2)");
    util_tx_continuous_args.dig=arg_int1(NULL, "dig", "<DIG>", "<uint>   Digital gain trim ");
    util_tx_continuous_args.mix=arg_int1(NULL, "mix", "<MIX>", "<uint>   Radio Tx mixer gain trim, [0:15](15 corresponds to maximum gain, 1 LSB corresponds to 2dB step)");
    util_tx_continuous_args.pa=arg_int1(NULL, "pa", "<PA>", "<uint>   PA gain trim, [0:3]");
    util_tx_continuous_args.mod=arg_str1(NULL, "mod", "<MOD>", "<char>   Modulation type ['LORA','FSK','CW']");
    util_tx_continuous_args.sf=arg_int1(NULL, "sf", "<SF>", "<uint>   LoRa Spreading Factor, [7:12]");
    util_tx_continuous_args.bw=arg_int1(NULL, "bw", "<BW>", "<uint>   LoRa bandwidth in kHz, [125,250,500]");
    util_tx_continuous_args.br=arg_dbl1(NULL, "br", "<BR>", "<float>  FSK bitrate in kbps, [0.5:250]");
    util_tx_continuous_args.fdev=arg_int1(NULL, "fdev", "<FDEV>", "<uint>   FSK frequency deviation in kHz, [1:250]");
    util_tx_continuous_args.bt=arg_int1(NULL, "bt", "<BT>", "<uint>   FSK gaussian filter BT trim, [0:3]");
    util_tx_continuous_args.end= arg_end(12);

    const esp_console_cmd_t continuous_tx_cmd=
    {
        .command = "util_continuous_tx",
        .help = "Run continuous tx test",
        .hint = NULL,
        .func = &util_tx_continuous,
        .argtable = &util_tx_continuous_args
    };

    ESP_ERROR_CHECK( esp_console_cmd_register(&continuous_tx_cmd) );
}
/* --- EOF --- */
