Kiogora/esp32_lora_gateway/firmware/cmdline_tests/cmd_loragw_cal.c

/*
 / _____)             _              | |
( (____  _____ ____ _| |_ _____  ____| |__
 \____ \| ___ |    (_   _) ___ |/ ___)  _ \
 _____) ) ____| | | || |_| ____( (___| | | |
(______/|_____)_|_|_| \__)_____)\____)_| |_|
  (C)2013 Semtech-Cycleo

Description:
    Minimum test program for the loragw_hal 'library'

License: Revised BSD License, see LICENSE.TXT file include in the project
Maintainer: Sylvain Miermont
*/


/* -------------------------------------------------------------------------- */
/* --- DEPENDANCIES --------------------------------------------------------- */
#include <math.h>       /* cos */
#include <stdint.h>        /* C99 types */
#include <stdbool.h>       /* bool type */
#include <stdio.h>
#include <string.h>
#include <ctype.h>
#include "esp_log.h"
#include "esp_console.h"
#include "esp_system.h"
#include "argtable3/argtable3.h"
#include "cmd_decl.h"
#include "freertos/FreeRTOS.h"
#include "freertos/task.h"

#include "loragw_hal.h"
#include "loragw_reg.h"
#include "loragw_aux.h"
#include "loragw_radio.h"

#define SPI_SPEED 8000000

/* -------------------------------------------------------------------------- */
/* --- PRIVATE MACROS ------------------------------------------------------- */

#define ARRAY_SIZE(a) (sizeof(a) / sizeof((a)[0]))

/* -------------------------------------------------------------------------- */
/* --- PRIVATE CONSTANTS ---------------------------------------------------- */

#define DEFAULT_TX_NOTCH_FREQ   129E3
#define DEFAULT_RSSI_OFFSET     0.0
#define NB_CAL_MAX              100
#define MCU_AGC                 1
#define MCU_AGC_FW_BYTE         8192 /* size of the firmware IN BYTES (= twice the number of 14b words) */
#define FW_VERSION_ADDR         0x20
#define FW_VERSION_CAL          2
#define RAM_SIZE                4096
#define FREQ_SIG_NORM           0.078125

#include "cal_fw.var" /* external definition of the variable */
/* -------------------------------------------------------------------------- */
/* --- PRIVATE VARIABLES ---------------------------------------------------- */

/* -------------------------------------------------------------------------- */
/* --- PRIVATE TYPES --------------------------------------------------------- */

struct cal_res_s
{
    int8_t amp_a;
    int8_t phi_a;
    int8_t amp_b;
    int8_t phi_b;
    int8_t offset_i_a [8];
    int8_t offset_q_a [8];
    int8_t offset_i_b [8];
    int8_t offset_q_b [8];
    uint8_t img_rej_a;
    uint8_t img_rej_b;
    uint8_t offset_rej_a [8];
    uint8_t offset_rej_b [8];
    uint8_t debug [8];
};

/* -------------------------------------------------------------------------- */
/* --- PRIVATE FUNCTIONS DECLARATION ---------------------------------------- */

static char* TAG = "[UTIL_LORAGW_CAL]"; 

static uint8_t sx125x_cal(uint8_t cal_cmd, struct cal_res_s *cal_res);

static int read_capture(int16_t *i, int16_t *q, int nb_samp);

static uint8_t get_img_rej(int16_t *sig_i, int16_t *sig_q, int nb_samp, double f_sig_norm);

static struct
{
    struct arg_dbl *a;
    struct arg_dbl *b;
    struct arg_int *r;
    struct arg_int *n;
    struct arg_int *k;
    struct arg_int *t;
    struct arg_end *end;
} loragw_cal_args;

static int loragw_cal_test(int argc, char **argv)
{
    int i, j, x;
    int32_t read_val;
    struct lgw_conf_board_s boardconf;
    struct lgw_conf_rxrf_s rfconf;
    uint8_t fw_version;
    uint8_t cal_cmd;
    uint8_t cal_status;
    struct cal_res_s cal_res [NB_CAL_MAX];
    struct cal_res_s cal_res_max;
    struct cal_res_s cal_res_min;
    int16_t sig_i [RAM_SIZE];
    int16_t sig_q [RAM_SIZE];
    uint8_t img_rej_a [NB_CAL_MAX];
    uint8_t img_rej_b [NB_CAL_MAX];
    uint8_t img_rej_a_max;
    uint8_t img_rej_a_min;
    uint8_t img_rej_b_max;
    uint8_t img_rej_b_min;
    //FILE *file;

    /* command line options */
    uint32_t fa = 0, fb = 0;
    enum lgw_radio_type_e radio_type = LGW_RADIO_TYPE_NONE;
    uint8_t clocksource = 1; /* Radio B is source by default */
    uint8_t tx_enable = 0;
    int nb_cal = 5;

    int nerrors = arg_parse(argc, argv, (void**) &loragw_cal_args);
    if (nerrors != 0)
    {
        if(nerrors == 2)
        {
            if(loragw_cal_args.k->count == 0 && loragw_cal_args.t->count == 0)
            {
                ESP_LOGI(TAG, "Using default value for option k and t");
            }
            else
            {
                arg_print_errors(stderr, loragw_cal_args.end, argv[0]);
                return 1;
            }
        }
        else if(nerrors == 1)
        {
            if(loragw_cal_args.k->count == 0)
            {
                ESP_LOGI(TAG, "Using default value for option k");
            }
            else if( loragw_cal_args.t->count == 0)
            {
                ESP_LOGI(TAG, "Using default value for option t");
            }
            else
            {
                arg_print_errors(stderr, loragw_cal_args.end, argv[0]);
                return 1; 
            }
        }
        else
        {
            arg_print_errors(stderr, loragw_cal_args.end, argv[0]);
            return 1;
        }   
    }

    fa = (uint32_t)(((loragw_cal_args.a->dval[0])*1e6) + 0.5);
    fb = (uint32_t)(((loragw_cal_args.b->dval[0])*1e6) + 0.5);
    tx_enable = (uint8_t)(loragw_cal_args.t->ival[0]);
    switch(loragw_cal_args.r->ival[0])
    {
        case 1255:
            radio_type = LGW_RADIO_TYPE_SX1255;
            break;
        case 1257:
            radio_type = LGW_RADIO_TYPE_SX1257;
            break;
        default:
            return -1;
    }
    clocksource = (uint8_t)loragw_cal_args.k->ival[0];
    if(loragw_cal_args.n->count != 1 || ((unsigned int)(loragw_cal_args.n->ival[0]) > NB_CAL_MAX)|| ((unsigned int)(loragw_cal_args.n->ival[0]) < 1))
    {
        ESP_LOGE(TAG, "ERROR: invalid number of calibration iterations (MAX %d)",NB_CAL_MAX);
        return 1;
    }
    else
    {
        nb_cal = (unsigned int)(loragw_cal_args.n->ival[0]);
    }  
    /* check input parameters */
    if ((fa == 0) || (fb == 0))
    {
        ESP_LOGE(TAG, "ERROR: missing frequency input parameter:");
        ESP_LOGE(TAG, "  Radio A RX: %u", fa);
        ESP_LOGE(TAG, "  Radio B RX: %u", fb);
        return -1;
    }

    if (radio_type == LGW_RADIO_TYPE_NONE)
    {
        return -1;
    }

    /* starting the concentrator */
    /* board config */
    memset(&boardconf, 0, sizeof(boardconf));

    boardconf.lorawan_public = true;
    boardconf.clksrc = clocksource;
    lgw_board_setconf(boardconf);

    /* RF config */
    memset(&rfconf, 0, sizeof(rfconf));

    rfconf.enable = true;
    rfconf.freq_hz = fa;
    rfconf.rssi_offset = DEFAULT_RSSI_OFFSET;
    rfconf.type = radio_type;
    rfconf.tx_enable = false; /* ignored */
    lgw_rxrf_setconf(0, rfconf);

    rfconf.freq_hz = fb;
    rfconf.tx_enable = false; /* ignored */
    lgw_rxrf_setconf(1, rfconf);

    /* Calibration command */
    cal_cmd = 0;
    //cal_cmd |= 0x01; /* Bit 0: Calibrate Rx IQ mismatch compensation on radio A */
    //cal_cmd |= 0x02; /* Bit 1: Calibrate Rx IQ mismatch compensation on radio B */
    //cal_cmd |= 0x04; /* Bit 2: Calibrate Tx DC offset on radio A */
    //cal_cmd |= 0x08; /* Bit 3: Calibrate Tx DC offset on radio B */
    cal_cmd |= 0x10; /* Bit 4: 0: calibrate with DAC gain=2, 1: with DAC gain=3 (use 3) */

    switch (radio_type)
    {
        case LGW_RADIO_TYPE_SX1255:
            cal_cmd |= 0x20; /* Bit 5: 0: SX1257, 1: SX1255 */
            break;
        case LGW_RADIO_TYPE_SX1257:
            cal_cmd |= 0x00; /* Bit 5: 0: SX1257, 1: SX1255 */
            break;
        default:
            break;
    }

    cal_cmd |= 0x00; /* Bit 6-7: Board type 0: ref, 1: FPGA, 3: board X */

    /* Recap parameters*/
    ESP_LOGI(TAG, "Library version information: %s", lgw_version_info());
    ESP_LOGI(TAG, "Radio type: %d",radio_type);
    ESP_LOGI(TAG, "Radio A frequency: %f MHz",fa/1e6);
    ESP_LOGI(TAG, "Radio B frequency: %f MHz",fb/1e6);
    ESP_LOGI(TAG, "Number of calibration iterations: %d",nb_cal);
    ESP_LOGI(TAG, "Calibration command: brd: %d, chip: %d, dac: %d", cal_cmd >> 6, 1257-2*((cal_cmd & 0x20) >> 5), 2+((cal_cmd & 0x10) >> 4));

    x = lgw_connect(false, DEFAULT_TX_NOTCH_FREQ, SPI_SPEED);
    if (x == -1) {
        ESP_LOGE(TAG, "ERROR: FAIL TO CONNECT BOARD");
        return -1;
    }

    /* reset the registers (also shuts the radios down) */
    lgw_soft_reset();

    /* ungate clocks (gated by default) */
    lgw_reg_w(LGW_GLOBAL_EN, 1);

    /* switch on and reset the radios (also starts the 32 MHz XTAL) */
    lgw_reg_w(LGW_RADIO_A_EN,1);
    lgw_reg_w(LGW_RADIO_B_EN,1);
    wait_ms(500); /* TODO: optimize */
    lgw_reg_w(LGW_RADIO_RST,1);
    wait_ms(5);
    lgw_reg_w(LGW_RADIO_RST,0);

    /* setup the radios */
    lgw_setup_sx125x(0, clocksource, true, radio_type, fa);
    lgw_setup_sx125x(1, clocksource, false, radio_type, fb);

    /* Set GPIO 4 high for calibration */
    lgw_reg_w(LGW_GPIO_MODE,31); /* Set all GPIOs as output */
    lgw_reg_w(LGW_GPIO_SELECT_OUTPUT,2); /* AGC MCU drives GPIOs */

    /* Load the calibration firmware  */
    load_firmware(MCU_AGC, cal_firmware, MCU_AGC_FW_BYTE);
    lgw_reg_w(LGW_MCU_RST_1,0);
    lgw_reg_w(LGW_DBG_AGC_MCU_RAM_ADDR, FW_VERSION_ADDR);
    lgw_reg_r(LGW_DBG_AGC_MCU_RAM_DATA, &read_val);
    fw_version = (uint8_t)read_val;
    if (fw_version != FW_VERSION_CAL)
    {
        ESP_LOGE(TAG, "ERROR: Version of calibration firmware not expected, actual:%d expected:%d", fw_version, FW_VERSION_CAL);
        lgw_disconnect();
        return -1;
    }

    /* Run Rx A IQ mismatch calibration only */
    for (i=0; i<nb_cal; i++)
    {
        cal_status = sx125x_cal(cal_cmd | 0x01, &cal_res[i]);
        x = read_capture(sig_i, sig_q, RAM_SIZE);
        /*
        file = fopen("toto.txt","w");
        for (j=0; j<RAM_SIZE; j++) {
            fESP_LOGI(TAG, file, "%d %d", sig_i[j], sig_q[j]);
        }
        fclose(file);
        */
        img_rej_a[i] = get_img_rej(sig_i, sig_q, RAM_SIZE, FREQ_SIG_NORM);

        ESP_LOGI(TAG, "Rx A IQ mismatch: Amp: %3d Phi: %3d Rej: %2d dB Status: %3d | Debug: Rej: %2d dB Lna: %1d BB: %2d Dec: %2d", cal_res[i].amp_a, cal_res[i].phi_a, cal_res[i].img_rej_a, cal_status, img_rej_a[i], cal_res[i].debug[0], cal_res[i].debug[1], cal_res[i].debug[2]);
    }

    /* Run Rx B IQ mismatch calibation only */
    for (i=0; i<nb_cal; i++)
    {
        cal_status = sx125x_cal(cal_cmd | 0x02, &cal_res[i]);
        x = read_capture(sig_i, sig_q, RAM_SIZE);
        img_rej_b[i] = get_img_rej(sig_i, sig_q, RAM_SIZE, FREQ_SIG_NORM);

        ESP_LOGI(TAG, "Rx B IQ mismatch: Amp: %3d Phi: %3d Rej: %2d dB Status: %3d | Debug: Rej: %2d dB Lna: %1d BB: %2d Dec: %2d", cal_res[i].amp_b, cal_res[i].phi_b, cal_res[i].img_rej_b, cal_status, img_rej_b[i], cal_res[i].debug[0], cal_res[i].debug[1], cal_res[i].debug[2]);
    }

    /* Run Tx A DC offset calibation only */
    if ((tx_enable == 1) || (tx_enable == 3)) {
        for (i=0; i<nb_cal; i++) {
            cal_status = sx125x_cal(cal_cmd | 0x04, &cal_res[i]);

            ESP_LOGI(TAG, "Tx A DC offset I :");
            for (j=0; j<8; j++) {
                ESP_LOGI(TAG, " %3d", cal_res[i].offset_i_a[j]);
            }
            ESP_LOGI(TAG, "Tx A DC offset Q :");
            for (j=0; j<8; j++) {
                ESP_LOGI(TAG, " %3d", cal_res[i].offset_q_a[j]);
            }
            ESP_LOGI(TAG, "Tx A DC rejection:");
            for (j=0; j<8; j++) {
                ESP_LOGI(TAG, " %3d", cal_res[i].offset_rej_a[j]);
            }
            ESP_LOGI(TAG, "Tx A DC debug BB :");
            for (j=0; j<8; j++) {
                ESP_LOGI(TAG, " %3d", (cal_res[i].debug[j] & 0xF0) >> 4);
            }
            ESP_LOGI(TAG, "Tx A DC debug Dec:");
            for (j=0; j<8; j++) {
                ESP_LOGI(TAG, " %3d", cal_res[i].debug[j] & 0x0F);
            }
            ESP_LOGI(TAG, "Tx A DC Status   : %3d", cal_status);
        }
    } else {
        ESP_LOGI(TAG, "Tx A calibration bypassed");
    }

    /* Run Tx B DC offset calibation only */
    if ((tx_enable == 2) || (tx_enable == 3)) {
        for (i=0; i<nb_cal; i++) {
            cal_status = sx125x_cal(cal_cmd | 0x08, &cal_res[i]);

            ESP_LOGI(TAG, "Tx B DC offset I :");
            for (j=0; j<8; j++) {
                ESP_LOGI(TAG, " %3d", cal_res[i].offset_i_b[j]);
            }
            ESP_LOGI(TAG, "Tx B DC offset Q :");
            for (j=0; j<8; j++) {
                ESP_LOGI(TAG, " %3d", cal_res[i].offset_q_b[j]);
            }
            ESP_LOGI(TAG, "Tx B DC rejection:");
            for (j=0; j<8; j++) {
                ESP_LOGI(TAG, " %3d", cal_res[i].offset_rej_b[j]);
            }
            ESP_LOGI(TAG, "Tx B DC debug BB :");
            for (j=0; j<8; j++) {
                ESP_LOGI(TAG, " %3d", (cal_res[i].debug[j] & 0xF0) >> 4);
            }
            ESP_LOGI(TAG, "Tx B DC debug Dec:");
            for (j=0; j<8; j++) {
                ESP_LOGI(TAG, " %3d", cal_res[i].debug[j] & 0x0F);
            }
            ESP_LOGI(TAG, "Tx B DC Status   : %3d", cal_status);
        }
    }  else {
        ESP_LOGI(TAG, "Tx B calibration bypassed");
    }

    /* Compute statistics */
    cal_res_max.amp_a = -128;
    cal_res_max.phi_a = -128;
    cal_res_max.amp_b = -128;
    cal_res_max.phi_b = -128;
    cal_res_max.img_rej_a = 0;
    cal_res_max.img_rej_b = 0;
    for (j=0; j<8; j++) 
    {
        cal_res_max.offset_i_a[j] = -128;
        cal_res_max.offset_q_a[j] = -128;
        cal_res_max.offset_i_b[j] = -128;
        cal_res_max.offset_q_b[j] = -128;
        cal_res_max.offset_rej_a[j] = 0;
        cal_res_max.offset_rej_b[j] = 0;
    }

    cal_res_min.amp_a = 127;
    cal_res_min.phi_a = 127;
    cal_res_min.amp_b = 127;
    cal_res_min.phi_b = 127;
    cal_res_min.img_rej_a = 255;
    cal_res_min.img_rej_b = 255;
    for (j=0; j<8; j++)
    {
        cal_res_min.offset_i_a[j] = 127;
        cal_res_min.offset_q_a[j] = 127;
        cal_res_min.offset_i_b[j] = 127;
        cal_res_min.offset_q_b[j] = 127;
        cal_res_min.offset_rej_a[j] = 255;
        cal_res_min.offset_rej_b[j] = 255;
    }

    img_rej_a_max = 0;
    img_rej_a_min = 255;
    img_rej_b_max = 0;
    img_rej_b_min = 255;

    for (i=0; i<nb_cal; i++) {
        if (cal_res[i].amp_a > cal_res_max.amp_a) {
            cal_res_max.amp_a = cal_res[i].amp_a;
        }
        if (cal_res[i].phi_a > cal_res_max.phi_a) {
            cal_res_max.phi_a = cal_res[i].phi_a;
        }
        if (cal_res[i].amp_b > cal_res_max.amp_b) {
            cal_res_max.amp_b = cal_res[i].amp_b;
        }
        if (cal_res[i].phi_b > cal_res_max.phi_b) {
            cal_res_max.phi_b = cal_res[i].phi_b;
        }
        if (cal_res[i].phi_b > cal_res_max.phi_b) {
            cal_res_max.phi_b = cal_res[i].phi_b;
        }
        if (cal_res[i].img_rej_a > cal_res_max.img_rej_a) {
            cal_res_max.img_rej_a = cal_res[i].img_rej_a;
        }
        if (cal_res[i].img_rej_b > cal_res_max.img_rej_b) {
            cal_res_max.img_rej_b = cal_res[i].img_rej_b;
        }
        for (j=0; j<8; j++) {
            if (cal_res[i].offset_i_a[j]  > cal_res_max.offset_i_a[j]) {
                cal_res_max.offset_i_a[j] = cal_res[i].offset_i_a[j];
            }
            if (cal_res[i].offset_q_a[j] > cal_res_max.offset_q_a[j]) {
                cal_res_max.offset_q_a[j] = cal_res[i].offset_q_a[j];
            }
            if (cal_res[i].offset_i_b[j] > cal_res_max.offset_i_b[j]) {
                cal_res_max.offset_i_b[j] = cal_res[i].offset_i_b[j];
            }
            if (cal_res[i].offset_q_b[j] > cal_res_max.offset_q_b[j]) {
                cal_res_max.offset_q_b[j] = cal_res[i].offset_q_b[j];
            }
            if (cal_res[i].offset_rej_a[j] > cal_res_max.offset_rej_a[j]) {
                cal_res_max.offset_rej_a[j] = cal_res[i].offset_rej_a[j];
            }
            if (cal_res[i].offset_rej_b[j] > cal_res_max.offset_rej_b[j]) {
                cal_res_max.offset_rej_b[j] = cal_res[i].offset_rej_b[j];
            }
        }

        if (cal_res[i].amp_a < cal_res_min.amp_a) {
            cal_res_min.amp_a = cal_res[i].amp_a;
        }
        if (cal_res[i].phi_a < cal_res_min.phi_a) {
            cal_res_min.phi_a = cal_res[i].phi_a;
        }
        if (cal_res[i].amp_b < cal_res_min.amp_b) {
            cal_res_min.amp_b = cal_res[i].amp_b;
        }
        if (cal_res[i].phi_b < cal_res_min.phi_b) {
            cal_res_min.phi_b = cal_res[i].phi_b;
        }
        if (cal_res[i].phi_b < cal_res_min.phi_b) {
            cal_res_min.phi_b = cal_res[i].phi_b;
        }
        if (cal_res[i].img_rej_a < cal_res_min.img_rej_a) {
            cal_res_min.img_rej_a = cal_res[i].img_rej_a;
        }
        if (cal_res[i].img_rej_b < cal_res_min.img_rej_b) {
            cal_res_min.img_rej_b = cal_res[i].img_rej_b;
        }
        for (j=0; j<8; j++) {
            if (cal_res[i].offset_i_a[j] < cal_res_min.offset_i_a[j]) {
                cal_res_min.offset_i_a[j] = cal_res[i].offset_i_a[j];
            }
            if (cal_res[i].offset_q_a[j] < cal_res_min.offset_q_a[j]) {
                cal_res_min.offset_q_a[j] = cal_res[i].offset_q_a[j];
            }
            if (cal_res[i].offset_i_b[j] < cal_res_min.offset_i_b[j]) {
                cal_res_min.offset_i_b[j] = cal_res[i].offset_i_b[j];
            }
            if (cal_res[i].offset_q_b[j] < cal_res_min.offset_q_b[j]) {
                cal_res_min.offset_q_b[j] = cal_res[i].offset_q_b[j];
            }
            if (cal_res[i].offset_rej_a[j] < cal_res_min.offset_rej_a[j]) {
                cal_res_min.offset_rej_a[j] = cal_res[i].offset_rej_a[j];
            }
            if (cal_res[i].offset_rej_b[j] < cal_res_min.offset_rej_b[j]) {
                cal_res_min.offset_rej_b[j] = cal_res[i].offset_rej_b[j];
            }
        }

        if (img_rej_a[i] > img_rej_a_max) {
            img_rej_a_max = img_rej_a[i];
        }
        if (img_rej_a[i] < img_rej_a_min) {
            img_rej_a_min = img_rej_a[i];
        }
        if (img_rej_b[i] > img_rej_b_max) {
            img_rej_b_max = img_rej_b[i];
        }
        if (img_rej_b[i] < img_rej_b_min) {
            img_rej_b_min = img_rej_b[i];
        }
    }

    /* Print statistics */
    ESP_LOGI(TAG, "Rx A IQ mismatch calibration statistics on %3d iterations (min, max):", nb_cal);
    ESP_LOGI(TAG, "Amp: %3d %3d Phi: %3d %3d Rej: %2d %2d dB (capt.: %2d %2d dB)", cal_res_min.amp_a, cal_res_max.amp_a, cal_res_min.phi_a, cal_res_max.phi_a, cal_res_min.img_rej_a, cal_res_max.img_rej_a, img_rej_a_min, img_rej_a_max);

    ESP_LOGI(TAG, "Rx B IQ mismatch calibration statistics on %3d iterations (min, max):", nb_cal);
    ESP_LOGI(TAG, "Amp: %3d %3d Phi: %3d %3d Rej: %2d %2d dB (capt.: %2d %2d dB)", cal_res_min.amp_b, cal_res_max.amp_b, cal_res_min.phi_b, cal_res_max.phi_b, cal_res_min.img_rej_b, cal_res_max.img_rej_b, img_rej_b_min, img_rej_b_max);

    if ((tx_enable == 1) || (tx_enable == 3)) {
        ESP_LOGI(TAG, "Tx A DC offset calibration statistics on %3d iterations (min, max):", nb_cal);
        for (j=0; j<8; j++) {
            ESP_LOGI(TAG, " Mix gain %2d: I: %3d %3d Q: %3d %3d Rej: %2d %2d dB", 8+j, cal_res_min.offset_i_a[j], cal_res_max.offset_i_a[j], cal_res_min.offset_q_a[j], cal_res_max.offset_q_a[j], cal_res_min.offset_rej_a[j], cal_res_max.offset_rej_a[j]);
        }
    }

    if ((tx_enable == 2) || (tx_enable == 3)) {
        ESP_LOGI(TAG, "Tx B DC offset calibration statistics on %3d iterations (min, max):", nb_cal);
        for (j=0; j<8; j++) {
            ESP_LOGI(TAG, " Mix gain %2d: I: %3d %3d Q: %3d %3d Rej: %2d %2d dB", 8+j, cal_res_min.offset_i_b[j], cal_res_max.offset_i_b[j], cal_res_min.offset_q_b[j], cal_res_max.offset_q_b[j], cal_res_min.offset_rej_b[j], cal_res_max.offset_rej_b[j]);
        }
    }

    lgw_disconnect();

    ESP_LOGI(TAG, "End of radio calibration test");

    return 0;
}

/* ~~~~~~~~~~~~~~~~~~~~~~~~~~~~~~~~ */

uint8_t sx125x_cal(uint8_t cal_cmd, struct cal_res_s *cal_res) {

    int i;
    int32_t read_val;
    uint8_t cal_status;

    lgw_reg_w(LGW_FORCE_HOST_RADIO_CTRL,0); /* gives to AGC MCU the control of the radios */
    lgw_reg_w(LGW_RADIO_SELECT,cal_cmd); /* send calibration configuration word */
    lgw_reg_w(LGW_MCU_RST_1,1);
    lgw_reg_w(LGW_MCU_RST_1,0);
    lgw_reg_w(LGW_PAGE_REG,3); /* Calibration will start on this condition as soon as MCU can talk to concentrator registers */
    lgw_reg_w(LGW_EMERGENCY_FORCE_HOST_CTRL,0); /* Give control of concentrator registers to MCU */

    wait_ms(2000); /* Wait for end of calibration */

    lgw_reg_w(LGW_EMERGENCY_FORCE_HOST_CTRL,1); /* Take back control */

    /* Get calibration status */
    lgw_reg_r(LGW_MCU_AGC_STATUS, &read_val);
    cal_status = (uint8_t)read_val;

    /* Check calibration flags
        bit 0: could access SX1301 registers
        bit 1: could access radio A registers
        bit 2: could access radio B registers
        bit 3: radio A RX image rejection successful
        bit 4: radio B RX image rejection successful
        bit 5: radio A TX imbalance correction successful
        bit 6: radio B TX imbalance correction successful
        bit 7: calibration finished */

    if ((cal_status & 0x01) == 0) {
        ESP_LOGW(TAG, "WARNING: calibration could not access SX1301 registers");
    }
    if ((cal_status & 0x02) == 0) {
        ESP_LOGW(TAG, "WARNING: calibration could not access radio A");
    }
    if ((cal_status & 0x04) == 0) {
        ESP_LOGW(TAG, "WARNING: calibration could not access radio B");
    }
    if ((cal_cmd & 0x01) && ((cal_status & 0x08) == 0)) {
        ESP_LOGW(TAG, "WARNING: problem in calibration of radio A for image rejection");
    }
    if ((cal_cmd & 0x02) && ((cal_status & 0x10) == 0)) {
        ESP_LOGW(TAG, "WARNING: problem in calibration of radio B for image rejection");
    }
    if ((cal_cmd & 0x04) && ((cal_status & 0x20) == 0)) {
        ESP_LOGW(TAG, "WARNING: problem in calibration of radio A for TX imbalance");
    }
    if ((cal_cmd & 0x08) && ((cal_status & 0x40) == 0)) {
        ESP_LOGW(TAG, "WARNING: problem in calibration of radio B for TX imbalance");
    }
    if ((cal_status & 0x80) == 0) {
        ESP_LOGW(TAG, "WARNING: Calibration not finished");
    }

    /* Get calibration results */
    if (cal_cmd & 0x01) {
        lgw_reg_r(LGW_IQ_MISMATCH_A_AMP_COEFF, &read_val);
        (*cal_res).amp_a = (int8_t)((read_val > 31) ? read_val - 64 : read_val);
        lgw_reg_r(LGW_IQ_MISMATCH_A_PHI_COEFF, &read_val);
        (*cal_res).phi_a = (int8_t)((read_val > 31) ? read_val - 64 : read_val);
        lgw_reg_w(LGW_DBG_AGC_MCU_RAM_ADDR, 0xD0);
        lgw_reg_r(LGW_DBG_AGC_MCU_RAM_DATA, &read_val);
        (*cal_res).img_rej_a = (uint8_t)read_val;
        lgw_reg_w(LGW_DBG_AGC_MCU_RAM_ADDR, 0xD2);
        lgw_reg_r(LGW_DBG_AGC_MCU_RAM_DATA, &read_val);
        (*cal_res).debug[0] = (uint8_t)read_val;
        lgw_reg_w(LGW_DBG_AGC_MCU_RAM_ADDR, 0xD3);
        lgw_reg_r(LGW_DBG_AGC_MCU_RAM_DATA, &read_val);
        (*cal_res).debug[1] = (uint8_t)read_val;
        lgw_reg_w(LGW_DBG_AGC_MCU_RAM_ADDR, 0xD4);
        lgw_reg_r(LGW_DBG_AGC_MCU_RAM_DATA, &read_val);
        (*cal_res).debug[2] = (uint8_t)read_val;
    }
    if (cal_cmd & 0x02) {
        lgw_reg_r(LGW_IQ_MISMATCH_B_AMP_COEFF, &read_val);
        (*cal_res).amp_b = (int8_t)((read_val > 31) ? read_val - 64 : read_val);
        lgw_reg_r(LGW_IQ_MISMATCH_B_PHI_COEFF, &read_val);
        (*cal_res).phi_b = (int8_t)((read_val > 31) ? read_val - 64 : read_val);
        lgw_reg_w(LGW_DBG_AGC_MCU_RAM_ADDR, 0xD1);
        lgw_reg_r(LGW_DBG_AGC_MCU_RAM_DATA, &read_val);
        (*cal_res).img_rej_b = (uint8_t)read_val;
        lgw_reg_w(LGW_DBG_AGC_MCU_RAM_ADDR, 0xD2);
        lgw_reg_r(LGW_DBG_AGC_MCU_RAM_DATA, &read_val);
        (*cal_res).debug[0] = (uint8_t)read_val;
        lgw_reg_w(LGW_DBG_AGC_MCU_RAM_ADDR, 0xD3);
        lgw_reg_r(LGW_DBG_AGC_MCU_RAM_DATA, &read_val);
        (*cal_res).debug[1] = (uint8_t)read_val;
        lgw_reg_w(LGW_DBG_AGC_MCU_RAM_ADDR, 0xD4);
        lgw_reg_r(LGW_DBG_AGC_MCU_RAM_DATA, &read_val);
        (*cal_res).debug[2] = (uint8_t)read_val;
    }
    if (cal_cmd & 0x04) {
        for (i=0; i<=7; ++i) {
            lgw_reg_w(LGW_DBG_AGC_MCU_RAM_ADDR, 0xA0+i);
            lgw_reg_r(LGW_DBG_AGC_MCU_RAM_DATA, &read_val);
            (*cal_res).offset_i_a[i] = (int8_t)read_val;
            lgw_reg_w(LGW_DBG_AGC_MCU_RAM_ADDR, 0xA8+i);
            lgw_reg_r(LGW_DBG_AGC_MCU_RAM_DATA, &read_val);
            (*cal_res).offset_q_a[i] = (int8_t)read_val;
            lgw_reg_w(LGW_DBG_AGC_MCU_RAM_ADDR, 0xC0+i);
            lgw_reg_r(LGW_DBG_AGC_MCU_RAM_DATA, &read_val);
            (*cal_res).offset_rej_a[i] = (uint8_t)read_val;
            lgw_reg_w(LGW_DBG_AGC_MCU_RAM_ADDR, 0xD2+i);
            lgw_reg_r(LGW_DBG_AGC_MCU_RAM_DATA, &read_val);
            (*cal_res).debug[i] = (uint8_t)read_val;
        }
    }
    if (cal_cmd & 0x08) {
        for (i=0; i<=7; ++i) {
            lgw_reg_w(LGW_DBG_AGC_MCU_RAM_ADDR, 0xB0+i);
            lgw_reg_r(LGW_DBG_AGC_MCU_RAM_DATA, &read_val);
            (*cal_res).offset_i_b[i] = (int8_t)read_val;
            lgw_reg_w(LGW_DBG_AGC_MCU_RAM_ADDR, 0xB8+i);
            lgw_reg_r(LGW_DBG_AGC_MCU_RAM_DATA, &read_val);
            (*cal_res).offset_q_b[i] = (int8_t)read_val;
            lgw_reg_w(LGW_DBG_AGC_MCU_RAM_ADDR, 0xC8+i);
            lgw_reg_r(LGW_DBG_AGC_MCU_RAM_DATA, &read_val);
            (*cal_res).offset_rej_b[i] = (uint8_t)read_val;
            lgw_reg_w(LGW_DBG_AGC_MCU_RAM_ADDR, 0xD2+i);
            lgw_reg_r(LGW_DBG_AGC_MCU_RAM_DATA, &read_val);
            (*cal_res).debug[i] = (uint8_t)read_val;
        }
    }

    return cal_status;
}

/* ~~~~~~~~~~~~~~~~~~~~~~~~~~~~~~~~ */

int read_capture(int16_t *sig_i, int16_t *sig_q, int nb_samp) {

    uint8_t read_burst[4];
    uint16_t data_i_c2;
    uint16_t data_q_c2;
    int i;

    lgw_reg_w(LGW_CAPTURE_RAM_ADDR, 0);
    for (i=0 ; i<nb_samp ; i++) {
        lgw_reg_rb(LGW_CAPTURE_RAM_DATA, read_burst, 4);
        data_i_c2 = ((uint16_t)read_burst[3] << 4) + ((uint16_t)read_burst[2] >> 4);
        data_q_c2 = ((uint16_t)read_burst[1] << 4) + ((uint16_t)read_burst[0] >> 4);
        sig_i[i] = (int16_t)((data_i_c2 > 2047) ? data_i_c2 - 4096 : data_i_c2);
        sig_q[i] = (int16_t)((data_q_c2 > 2047) ? data_q_c2 - 4096 : data_q_c2);
    }

    return 0;
}
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
