Kiogora/esp32_lora_gateway/(commit log)

2017-12-31 Semi-port spi driver to the esp32. Not yet tested
2017-12-31 Delete loragw_spi.ftdi.c
    Delete this driver for the freestanding ESP32 environment.
2017-12-31 Add esp32 template project for porting
2018-01-01 Tested SPI simple and burst reads
2018-01-03 Complete and approve unit test of SPI write operation
2018-01-07 Prep files for ESP32 porting
    1. The .h files and .c files added in a way compatible to the ESP32 build system.
    2. The gps header and ,c file is not involved in loragw at compile time.
    3. Rather the packet forwarder uses the the GPS implementation to obtian GPS time and update the concentrator counter over the SPI link.
    4. Latency of the SPI implementation for updating the GPS time may put the concentrators out sync, especially when using a non realtime OS.
    5. ESP32 allows the transfer to be deterministic and respond within a given amount of time.
2018-01-14 Convert the esp32 from from a unit test app to an actual project
    [test_partitions.csv]
2018-01-14 Complete porting of LoRa concentator calibration test
2018-01-15 Complete SPI stress test porting
2018-01-17 Rearrange folders and semiport tx test
    [library.cfg]
2018-01-24 Add performance comparison tests of esp32 vs rpi3
2018-01-27 Update loragw_spi.c
    1. Add explicit calls to lgw_close() func in lgw_open
    2. Dont check return value as probably a configuration and/or device may not have been added. Just force.
    4. Avoids us to call lgw_close explicitely if the open didn't exit nicely.
    [loragw_spi.c]
2018-01-27 Update loragw_reg.c
    1. Add explicit calls to lgw_disconnect in lgw_connect in case of error.
    2. As a device is configured and host added during this operations, any error doesnt allow us to use the spi host.
    3. We need to free this within the API so that it is invisible to the API user.
    [loragw_reg.c]
2018-01-27 Add concentrator restart if started
    1. Added a call to lgw_stop() in lgw_start() to catch exceptions when we try to start the concentrator when already started.
    2. Such an example is when doing testing with a menu such as normal of cmdline tests.
    3. Also there are times when we may want to restart the concentrator, we can do this by calling lgw_connect()
    4. How would this fare up when a restart happens while data is still in transit via DMA?
2018-01-29 Find a standard way of handling errors during and post concentrator connection
    1. Errors during connects are handled by the API, no need to call a disconnect() or stop() if a return value indicates error.
    2. Errors after succesful connect are the responsibility of the programmer using the API. One may disconnect or not disconnect.
    [cmd_loragw_cal.c, cmd_util_spi_stress.c, cmd_util_tx_continuous.c, loragw_hal.c, loragw_reg.c]
2018-02-05 Initial TTN gateway connector code
    1. Add code to connect to the gateway to a ttn test broker on local host on network.
    2. protobuf-c is directly ported from the online repo.
    3. protoc-c compiler is not used and any such code generation shall be done on the host not target.
    4. TODO - Port the packet forwarder and test with ttn. Port nanopb to the platform. Perform comparisons.
    [cmd_util_spi_stress.c, loragw_reg.c]
2018-02-13 Add preliminary files for porting of LoRanet/packet fowarder
    [test_partitions.csv]
2018-02-15 Add parson test files to command line tests
    1.This first loads a fatfs image for the command line then when parson is run, a spiffs image is loaded.
    2. Check why the spiffs image is not mounting. Gives error "Not a filesystem".
    [cmdline_partitions.csv, test_partitions.csv]
2018-02-15 Ported parson and parson tests in line with master
    1. This includes fixes that the LoRanet packet forwarder does not have.
    2. All tests passed except one as referenced https://github.com/kgabis/parson/issues/97
    [cmd_parson_test.c, console_main.c, main.cpp]
2018-02-22 Multiple commits in this commmit
    1. Reverted parson_test to the original without malloc checks.
    2. Completed loragw_gps. Removed timezone variable as the TZ variable will not be set, even when using SNTP.This above will set the time to UTC from NTP servers avoiding subrtraction of the timezone global variable.
    [cmd_parson_test.c, loragw_gps.c, test_loragw_gps.c]
2018-02-23 Add GCC debug switch case(-g) in makefile
    1. This provides symbols for valgrind to backtrace.
    2. May solve reason we cant unpack SPIFFS image read from esp32 flash.
2018-02-24 Correct error preventing mkspiffs unpacking
    1. The unpacking of current directory . of a folder always returned a NULL.
    2. Add necessary check for NULL pointer return value and ignore the "." file.
    3. Sample output:
    >>> spiffs image content:/.
    >>> Failed to open file, is this the current folder representation "."? Ignoring...
    >>> /. > ./foo/. size: 0 Bytes#
    4. Add md5 checksums for convenience but they usually dont match due to compression during flashing.
    5. Modify Makefile.projbuild accordingly.
    [main.cpp]
2018-02-24 Ported packet logger utility
    1. The rollover time is not accurate when counting on the ESP32.
    2. It is best if such timekeep details are kept by a real time clock and a GPS used for synchronisation.
    3. The timespec structure was not used, replaced with timeval instead. Couldnt find compatible clock_gettime() func.
    4. Unix system function access was not used for checking file permissions. Incompatible.
    5. The logging, readback and unpacking works very well.
    6. No memory leaks from parson so far.
    7. Use this example to port to a protobuf file in future.
    8. In future, if there is no internet access on the esp32, the files should be stored as protobuf format and sent when access is available.
    [cmd_decl.h, cmd_parson_test.c, cmd_util_pkt_logger.c, console_main.c]
2018-02-24 Correct timing
    1. Eliminate wrong parameter casting. The rollover time was being cast to uint8 datatype hence the early close of the write ops.
    [cmd_util_pkt_logger.c]
2018-02-26 Set update of time at start by SNTP protocol
    1.This allows the ESP32 to update its time by SNTP thus giving a relatively accurate UTC timestamp on the logs.
2018-02-27 Add project-local Unity test framework
    1. This is from src directory of commit hash 287e076 v2.4.3 of the Unity github repo https://github.com/ThrowTheSwitch/Unity/tree/v2.4.3 .
    2. This would allow running true unit tests within the cmdline tests.
    3. The tests should be ported from ESP-IDF unity tests to project local unity tests.
2018-02-27 Add timersync component
2018-03-06 Successfully port UDP packet forwarder
    1. This works very well with the things network
    2. GPS not yet tested.
    3. In future the current times should be made by an external RTC in the case of lack of network access.
    4. In the case (3), the messages should be cached locally in the case of lack of network access.
2018-03-10 Update timersync delay
    1. Reduced the timersync delay from 60sec to 8sec.
    2. The assumption on XTAL precision drift at 20ppm
    was not applicable.
    3. With 8 second delay, the timestamp was nearly accurate to the second.
    4. This should be retested.
2018-03-14 Add quectel-gsm component
    1. Its use has only been tested standalone outside the project.
    2. The project in its current state throws:
    fatal error: quectel_gsm.h: No such file or directory
    [quectel_gsm.c, quectel_gsm.h]
2018-03-17 Clean Loragw_spi
    1. Sanitised the log messages for spi component.
    2. Normal messages in this component is given as verbose(ESP_LOGV).
    3. Errors are treated as so.
    4. There may be a need to come up with unified error codes.
    [loragw_spi.c]
2018-03-17 Setup logging in loragw radio component
    1. Set up logging as verbose as this is low level.
    2. Unified error codes would be useful in a production environment.
    [loragw_radio.c]
2018-03-19 Add logging modification in spi read function.
2018-03-21 Update network tools
    1. Add ping standard deviation calculation.
    2. Format reporting similar to the nix ping command reports.
    3. Change ping command on cmdline to show sample arguments.
2018-03-22 Eliminate brackets around wifi password option
    1. This was caued by the expected string input being defined as var str0
    2. var0 such as str0, int0 means that the option need not be given.
    3. In the case of an open wifi network str0 is appropriate.
    4. Our test AP has a password though.
2018-03-22 Finalise logging in calibration test
2018-03-22 Remove "load firmware" function prototype from cmd_cal to hal component
    1. The prototype was missing from the hal header.
    [loragw_hal.h]
2018-03-22 Finalise porting of logging functions to ESP32 format ESP_LOGx
2018-03-27 Add prototype hardware files
    [prototype.kicad_pcb, prototype.sch]
2018-04-02 semi-finaliseprototype gateway design
    [prototype.sch]
2018-04-02 Add missing footprints
    1. Think about lightning protection and use of GDTs and TVSs
    2. Combine the various board and peripheral libraries into a single unified component.
    3. The component should have mounting holes suitable for standoffs and cable ties.
    [prototype.sch]
2018-04-19 prototype gateway PCB creation checkpoint
    [prototype.sch]
2018-04-22 Complete schematic less mikroe ug95 footprint
    [prototype.sch]
2018-04-23 Complete schematic design less footprint asignment completion
    [prototype.sch]
2018-04-26 Complete schematic and component footpint selection
    [prototype.sch]
2018-04-26 Layout part of the components
    [SYSTEM_LEDS.sch, prototype.sch]
2018-04-29 Complete PCB layout
    [SYSTEM_LEDS.sch, prototype.kicad_pcb, prototype.sch]
2018-04-29 Modify PCB layout
    [prototype.kicad_pcb]
2018-05-04 Complete PCB design, BOM generation and gerber generation
    [BOM_extras.sch, SYSTEM_LEDS.sch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]
2018-06-03 Add main file
    1. Update README
    2. Add BOM
    [BOM_extras.sch, pktlog_30AEA414D4380000_20180530T063539Z.csv, pktlog_30AEA414D4380000_20180530T064032Z.csv, pktlog_30AEA414D4380000_20180530T064305Z.csv, pktlog_30AEA414D4380000_20180530T065306Z.csv, pktlog_30AEA414D4380000_20180530T070307Z.csv, pktlog_30AEA414D4380000_20180530T081948Z.csv, pktlog_30AEA414D4380000_20180530T082049Z.csv]
2018-06-03 Move flash partitions csv to dedicated partitions folder
    [cmdline_partitions.csv]
2018-06-03 Rename esp32_port folder to firmware
    [cmdline_partitions.csv, pktlog_30AEA414D4380000_20180530T063539Z.csv, pktlog_30AEA414D4380000_20180530T064032Z.csv, pktlog_30AEA414D4380000_20180530T064305Z.csv, pktlog_30AEA414D4380000_20180530T065306Z.csv, pktlog_30AEA414D4380000_20180530T070307Z.csv, pktlog_30AEA414D4380000_20180530T081948Z.csv, pktlog_30AEA414D4380000_20180530T082049Z.csv]
2018-06-04 Port working of loragw GPS test
    1. Swapped RX and TX in code due to errata. This means TX cant work asit is on SVP which is input only.
    2. Set the uart reads to happen every one second.
    [prototype.kicad_pcb]
2018-06-04 Add prototype errata
2018-06-14 Add further investigation on spi boot error
2018-06-18 Add images on differences of esp32 core board versions
2018-06-18 Add TVS diode order mistake
